KevinEppacher/Awesome_Gripper/Bewegungsanalyse/SolidWorks/BA_Folge_3.JPG

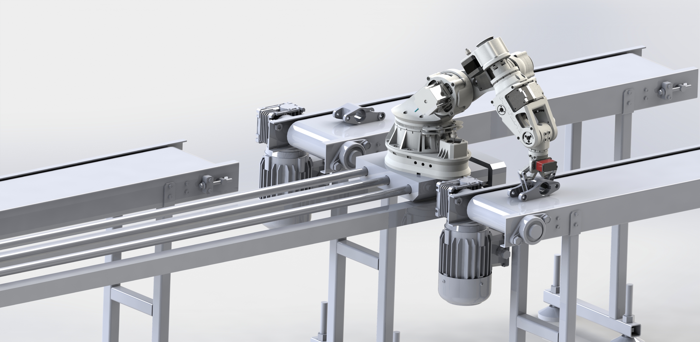
Bewegungsanalyse/SolidWorks/BA_Folge_3.JPG
