KevinEppacher/Awesome_Gripper/Bewegungsanalyse/SolidWorks/BA_Folge_1.JPG

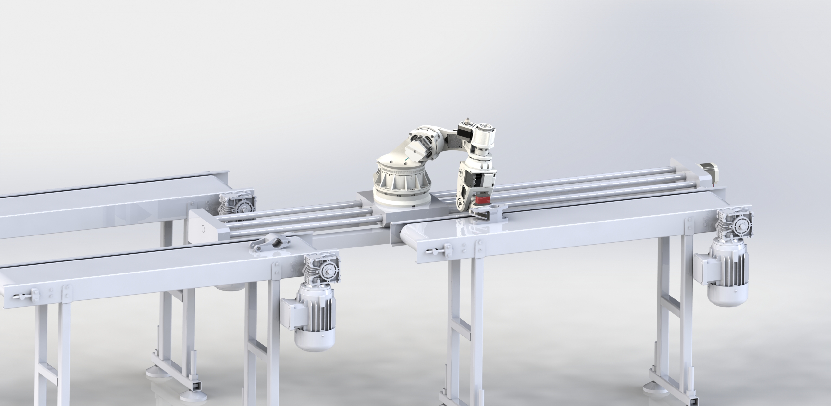
Bewegungsanalyse/SolidWorks/BA_Folge_1.JPG
