KevinEppacher/Awesome_Gripper/README.md

# Awesome_Gripper
Mechanical Gripper Development
