KevinEppacher/Awesome_Gripper/Dokumentation und Berechnung/Awesome_Gripper.docx

## Produktdesign und Produktentwicklung

## Greifer Entwicklung

Kevin Eppacher

Moritz Dönges

# Greif-Aufgabenstellung

Ziel ist es ein Werkstück, wie in Abbildung 1 dargestellt, von einem Förderband zu entnehmen und mittels einem geeigneten Endeffektor auf einem 6-Achs-Knickarm Roboter auf zwei Förderbänder abwechselnd zu manipulieren.

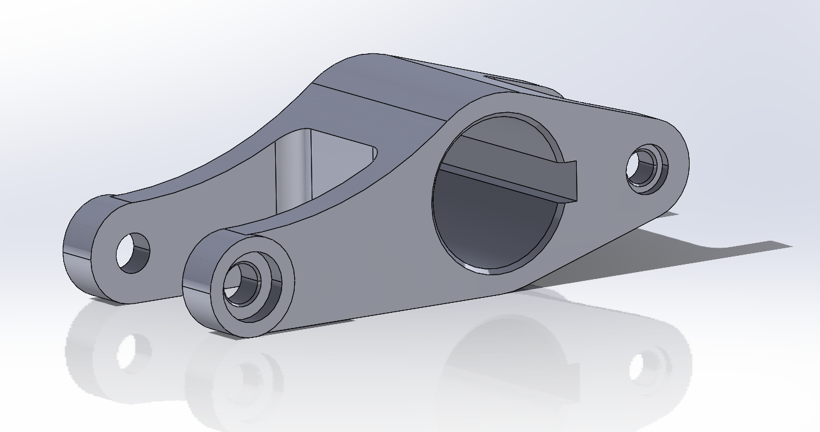
[picture p3: figure]

Abbildung 1: Werkstück

In Abbildung 2 ist die Anlage veranschaulicht. Die bearbeiteten Werkstücke kommen mittels einem Gurt-Förderband, welche durch einen Seitenanschlag positioniert werden. Die endgültige Position längs in Fahrtrichtung des Förderbandes, wird durch eine 2D-Kamera ermittelt, sodass der Roboter variabel die Werkstücke aufnehmen kann. Die Taktzeit beträgt 5 s vom Zeitpunkt der Entnahme des Werkstückes bis zur nächsten Entnahme des Werkstückes. Aus Taktzeitgründen, wird vorgesehen, dass ein Leichtbau Manipulator auf einer linear Schiene verfahrbar ist, um Werkstücke bereits am Anfang des Förderbandes zu entnehmen. Dies ermöglicht es, vorübergehend einen Zeitpuffer aufzubauen.

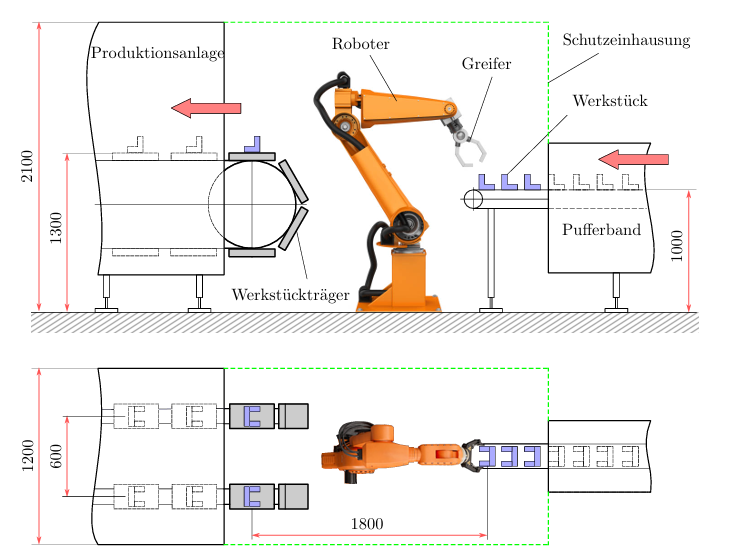
[picture p4: figure]

Abbildung 2: Anlagen Skizze

In Abbildung 3 (rechts) wird dargestellt, in welcher Orientierung das Werkstück auf dem Förderband ankommt und wie das Werkstück in welcher Orientierung platziert und abgeführt wird (links).

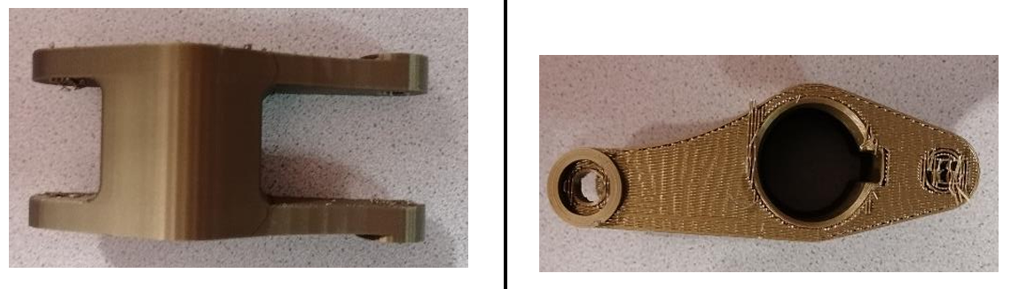
[picture p5: figure]

Abbildung 3: Bauteil Orientierung (Rechts – Zuführung | Links Abführung)

# Konstruktives Schema

Für die gegebene Aufgabenstellung wird ein parallel Backengreifer vorgesehen, mit einer kreisschiebenden Bewegung. Ein Parallel-Backengreifer mit Kreisschiebung kombiniert die Vorteile eines stabilen und kraftvollen Greifmechanismus mit hoher Präzision und Verschleißarmut. Er eignet sich besonders für automatisierte Produktionsprozesse, in denen eine zuverlässige und wiederholbare Bauteilhandhabung erforderlich ist.

Die Auslegung des Greifers hängt von folgenden Faktoren ab:

- Greif Merkmale
- Greifkraft
- Greifvolumen

Das Werkstück in Abbildung 1 eignet sich optimal mittig auf den seitlichen parallelen Flächen zu greifen. Der Abstand zwischen beiden Flächen beträgt 42 mm. Somit muss der Greifer für mindestens 42 mm ausgelegt werden, indem die Hebelarme des Parallel-Backengreifers dementsprechend lang genug konstruiert wird. Die notwendige Greifkraft wird in Kapitel “Greifkraft und Antrieb Berechnung“ näher erläutert. In Abbildung 4 ist eine schematische Skizze des Greifers dargestellt. Der Ordnungszustand des Werkstückes wird durch den Positionierungsgrad und dem Orientierungsgrad ermittelt. Obwohl das Werkstück auf dem Förderband mit einem seitlichen Anschlag zentriert wird, kann es sich in Längsrichtung des Förderbandes und in Querrichtung entlang der Auflagefläche frei bewegen. Zusätzlich kann das Werkstück sich auf dem Förderband entlang der z-Achse (orthogonal zur Auflagefläche des Förderbandes) frei bewegen. Aus dem ergibt sich folgender Positionierung (PG)-und Orientierungsgrad (OG):

PG: 1

OG: 1

Aus dem ergibt sich der ein Ordnungszustand (OG) von 1 (OG/PG). Ein OZ von 1 bedeutet, dass das Werkstück teilgeordnet im Raum ist. Um die Pose (bestehend aus Position und Orientierung) zu ermitteln, wird eine 2D-Kamera verwendet, um das Bauteil entlang und quer zum Förderband zu lokalisieren und um die Orientierung zu ermitteln.

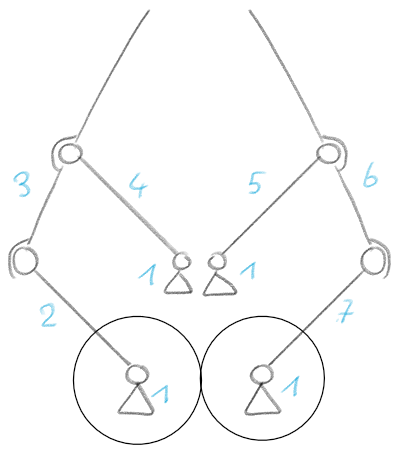
[picture p6: figure]
Freihandzeichnungen Freihandzeichnungen Freihandzeichnungen Freihandzeichnungen Freihandzeichnungen Freihandzeichnungen Freihandzeichnungen Freihandzeichnungen Freihandzeichnungen Freihandzeichnungen Freihandzeichnungen Freihandzeichnungen Freihandzeichnungen Freihandzeichnungen Freihandzeichnunge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

Abbildung 4: Schematische Skizze des Parallelbackengreifers

Das Bauteil besitzt mit dem vorgesehenen Greifer zwei Freiheitsgrade, da es sich entlang der Greiffläche bewegen kann. Diese Bewegungsmöglichkeit wird jedoch durch den erforderlichen Kraft- und Reibschluss kompensiert. Der Greifer setzt sich aus sieben Gliedern, acht Drehgelenken und einer kinematischen Zwangsbedingung zwischen dem Antriebszahnrad und dem Abriebzahnrad zusammen. In Abbildung 5 wird die kinematische Kette des Endeffektors illustriert, welches die Struktur und Anordnung der einzelnen Glieder sowie die Verbindungselemente darstellt. Die Kinematik des Systems basiert auf einer geschlossenen Viergelenkkette mit zusätzlichen Verbindungen, die eine synchrone Bewegung der Greifbacken ermöglichen.

Die nummerierten Gelenke in Abbildung 5 zeigen die Hauptbewegungspunkte des Mechanismus, wobei die Glieder durch Drehgelenke gekoppelt sind. Der zentrale Bereich (Glied 1) dient als Basisstruktur, an der die übrigen beweglichen Elemente angebracht sind. Durch die Zwangsbedingung zwischen dem Antriebszahnrad und dem Abriebzahnrad wird eine gleichmäßige Kraftübertragung auf beide Greifseiten gewährleistet, sodass eine symmetrische und präzise Greifbewegung ermöglicht wird.

Weiterhin sorgt die gewählte Kinematik für eine gleichmäßige Verteilung der Greifkräfte auf das Bauteil, wodurch eine zuverlässige Handhabung sichergestellt wird. Dies ist besonders wichtig, da sich das Werkstück entlang der Greiffläche bewegen könnte, falls der Kraft- und Reibschluss nicht ausreicht. Die Mechanik des Greifers minimiert dieses Risiko durch eine kontrollierte Bewegung und eine stabile Haltekraft.

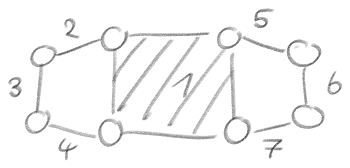
[picture p7: figure]
Freihandzeichnungen Freihandzeichnungen Freihandzeichnungen Freihandzeichnungen Freihandzeichnungen Freihandzeichnungen Freihandzeichnungen Freihandzeichnungen Freihandzeichnungen Freihandzeichnungen Freihandzeichnungen Freihandzeichnungen Freihandzeichnungen Freihandzeichnungen Freihandzeichnunge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

Abbildung 5: Kinematische Kette des 7-gliedrigen Greifers

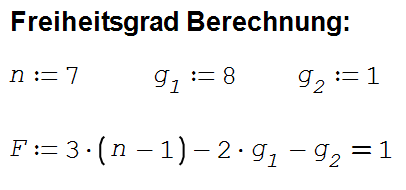
[picture p8: figure]

# Greifkraft und Antrieb Berechnung

Randbedingungen für die Greifkraft Berechnung:

- Masse = 0.42 kg
- Taktzeit = 5 s
- Roboter maximale TCP-Geschwindigkeit = 1.2 m/s

Die Masse des Werkstückes wurde in SolidWorks (SW) mittels den Materialeigenschaften (0.7050 Gusseisen) ermittelt. Die Taktzeit wurde vorgegeben durch die Materialflussgeschwindigkeit der vorherigen Anlage und eine maximale TCP-Geschwindigkeit von 1.2 m/s.

Folgende Annahmen wurden für die Greifkraft Berechnung angenommen:

Sicherheit = 2

Reibkoeffizient = 0.45

Um etwaige Modellunsicherheiten zu kompensieren, wurde mit einer Sicherheit von 2 gerechnet und der Reibkoeffizient ergibt sich aus den Materialeigenschaften zwischen Gummi (TPU) und Gusseisen (0.7050) und wurde aus den Kenndaten im Buch [1] ermittelt.

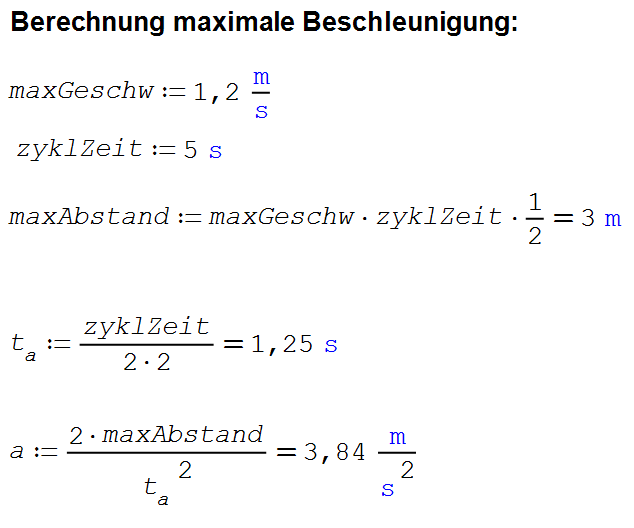
[picture p9: figure]

Der maximale Abstand zwischen der Pick- und Place-Position wird berechnet, indem die maximale Geschwindigkeit mit der halben Taktzeit multipliziert wird.

Zur vereinfachten Berechnung der maximalen Beschleunigung beim Anheben des Werkstücks wird angenommen, dass die Geschwindigkeit zu Beginn v=0 ist und die Beschleunigung ihren Höchstwert bei der Hälfte des Verfahrwegs erreicht.

Mithilfe der allgemeinen Bewegungsgleichung wird die Beschleunigung a hergeleitet. Da sowohl die Zeit, zu der die maximale Beschleunigung auftritt, als auch der maximale Abstand bekannt sind, kann die Beschleunigung direkt berechnet werden.

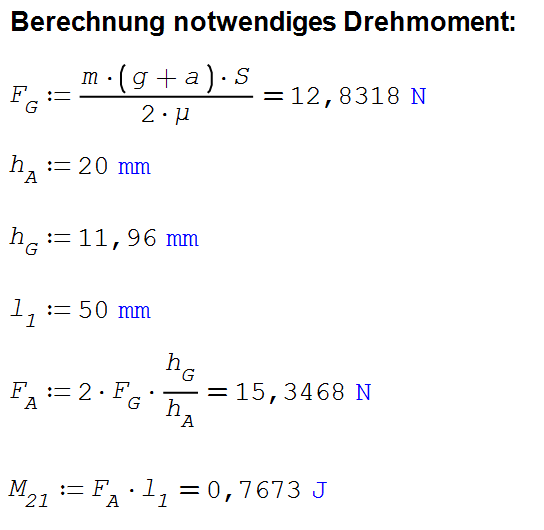
[picture p10: figure]

Dadurch dass zwei Greiferbacken das Werkstück abhängig der Gravitationsbeschleunigung und der höchst Beschleunigung mit einem Reibkoeffizienten μ festhalten, kann die notwendige Greifkraft berechnet werden. Mittels der h-Strecken Methode, wird im Punkt A (Abbildung 6) die notwendige Kraft berechnet, durch den h-Strecken Verhältnis am Greifpunkt relativ zu Punkt A. Aus der Länge des Hebels für Glied 2 und 7 (Abbildung 4), kann das notwendige Moment berechnet werden.

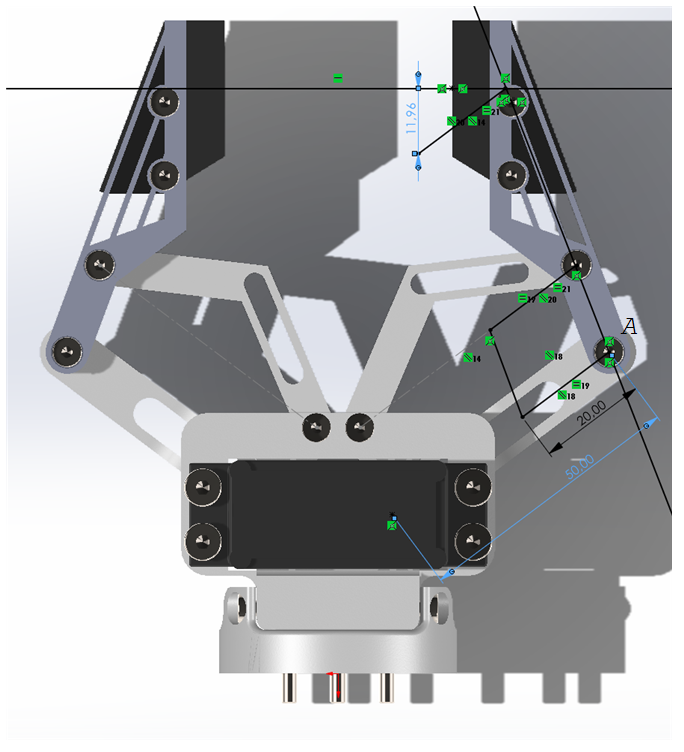
[picture p11: figure]

Abbildung 6: Grafische Berechnung der Kraft im Punkt A mittels der h-Strecken Methode

Es wurde ein Servo DC-Motor mit einem Drehmoment von 20 kgcm bzw. 1.96 Nm vorgesehen. Aus dem notwendigen Moment und dem Drehmoment des Servo Motors, ergibt sich eine Sicherheit von über 2.5.

# Analytische und Numerische Auslegung

Es wurde eine analytische Festigkeitsberechnung für Glieder 2 und 7 berechnet (siehe Abbildung 4), da es durch den vorgesehenen Design Material Ersparnis, aufgrund der kleinen Fläche zur höchsten Spannung führen könnte. Die Zugspannung lässt sich geometrisch ableiten (siehe Abbildung 7), indem die am Punkt A wirkende Kraft in ihre Längs- und Querkomponenten zerlegt wird.

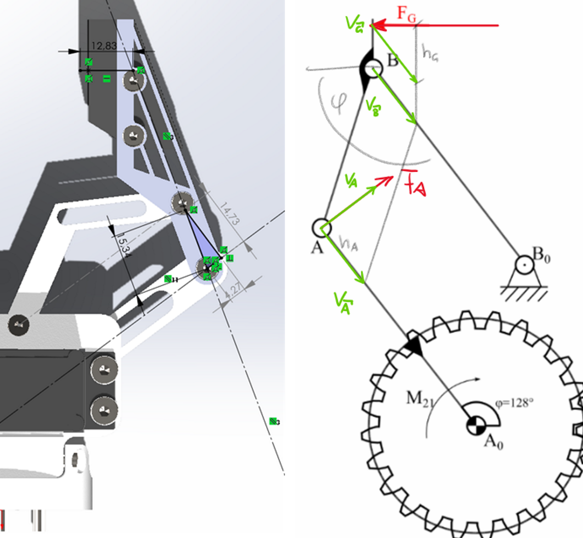
[picture p12: figure]

Abbildung 7: Geometrische Herleitung der Zugspannung auf das 2 und 7 Glied des Endeffektors

Mittels des Querschnittes des Bauteils, welches mittels SolidWorks ermittelt wurde, kann die Spannung in folgender Gleichung berechnet werden.

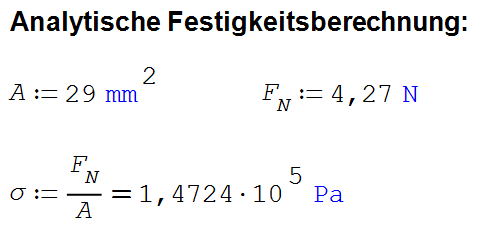
[picture p13: figure]

Im Dokument unter "Awesome_Gripper/Dokumentation und Berechnung/PLA_Materialeigenschaften.pdf" ist die Streckspannung des verwendeten PLA-Materials aufgeführt. Diese wird in der folgenden Berechnung zur Ermittlung des Sicherheitsfaktors verwendet, indem die auf das Bauteil wirkende Spannung durch die Streckspannung dividiert wird.

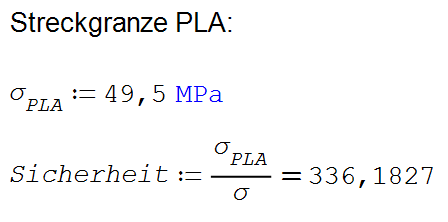
[picture p14: figure]

Daraus ergibt sich ein Sicherheitsfaktor von 336.

# Konstruktive Gestaltung

Die Konstruktion und die FE-Analyse wurden in Autodesk Fusion 360 umgesetzt. Der Greifer setzt sich aus 7 verschiedenen Teilen zusammen, wobei der Finger 4-mal und Tip und Support Lever 2-mal verbaut sind (siehe Zeichnung).

Element | Anzahl | Bauteil
1 | 1 | Baseplate | PLA
2 | 1 | Frame | PLA
3 | 1 | Lever | PLA
4 | 2 | Support Lever | PLA
5 | 4 | Finger | PLA
6 | 2 | Tip | TPU
7 | 1 | Offset Lever | PLA

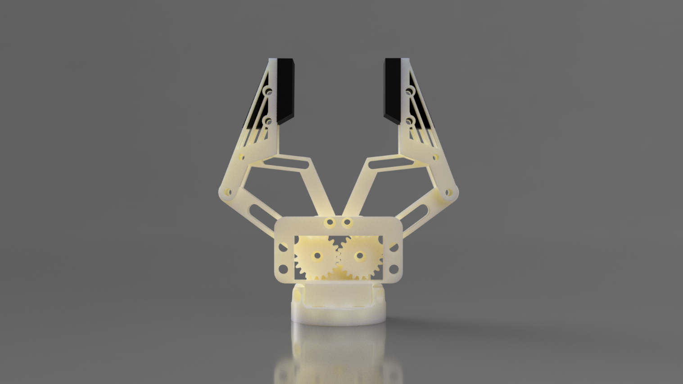
[picture p15: figure]

Abbildung 8: Greifer Baugruppe

# Ergebnisse FE-Analyse

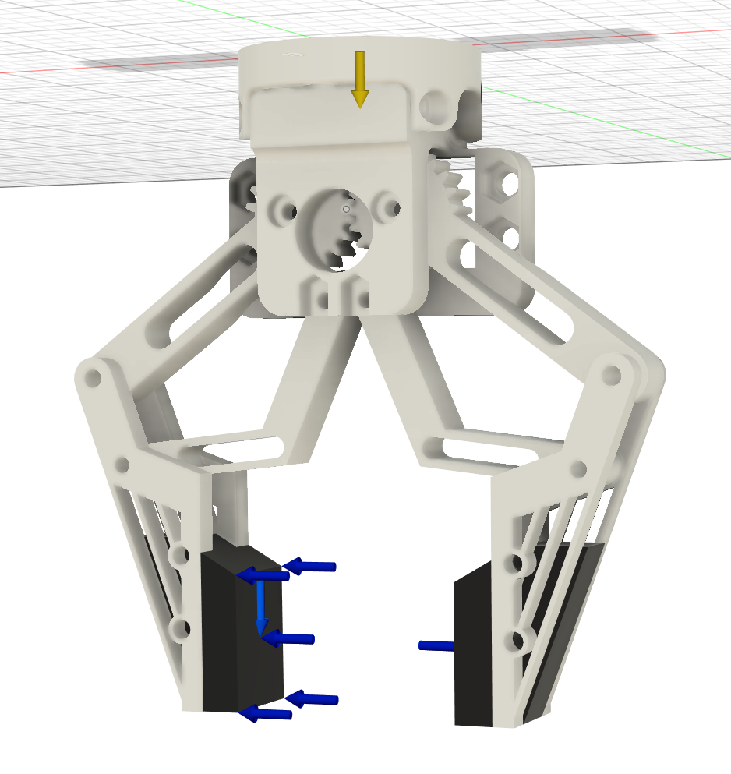
[picture p16: figure]

In Autodesk Fusion 360 wurde der Lastfall bei geschlossenem Greifer simuliert. Hierbei sind die Greiferbacken (Tip) 42 mm geöffnet. Die Greifkraft von 12.832 N wirkt auf die Greiferbacken, während die Normalkraft (Reibkraft) des Bauteils an den Oberflächen der Greiferbacken, durch die Schwerkraft, nach unten wirkt. Da das Bauteil mit dem Greifer gegriffen und nach oben bewegt wird, ergibt sich mit einer Bewegungsbeschleunigung von 3,84 m/s² eine Reibkraft von 2.882 N pro Greifbacke. Zudem wirkt die Schwerkraft, welche in der FE-Analyse als gelber Pfeil dargestellt ist.
Weitere Ergebnisse sind der Autodesk.html aus dem Ordner „Dokumentationen und Berechnung zu entnehmen.

Abbildung 9: Simulationskonfiguration der FE-Analyse. Greifkraft (dunkel Blau), Reibkraft (Blau), Schwerkraft (Gelb)

Ergebnisse

Die Baugruppe wurde auf Dehnung, Spannung und Verschiebung getestet:

Dehnung

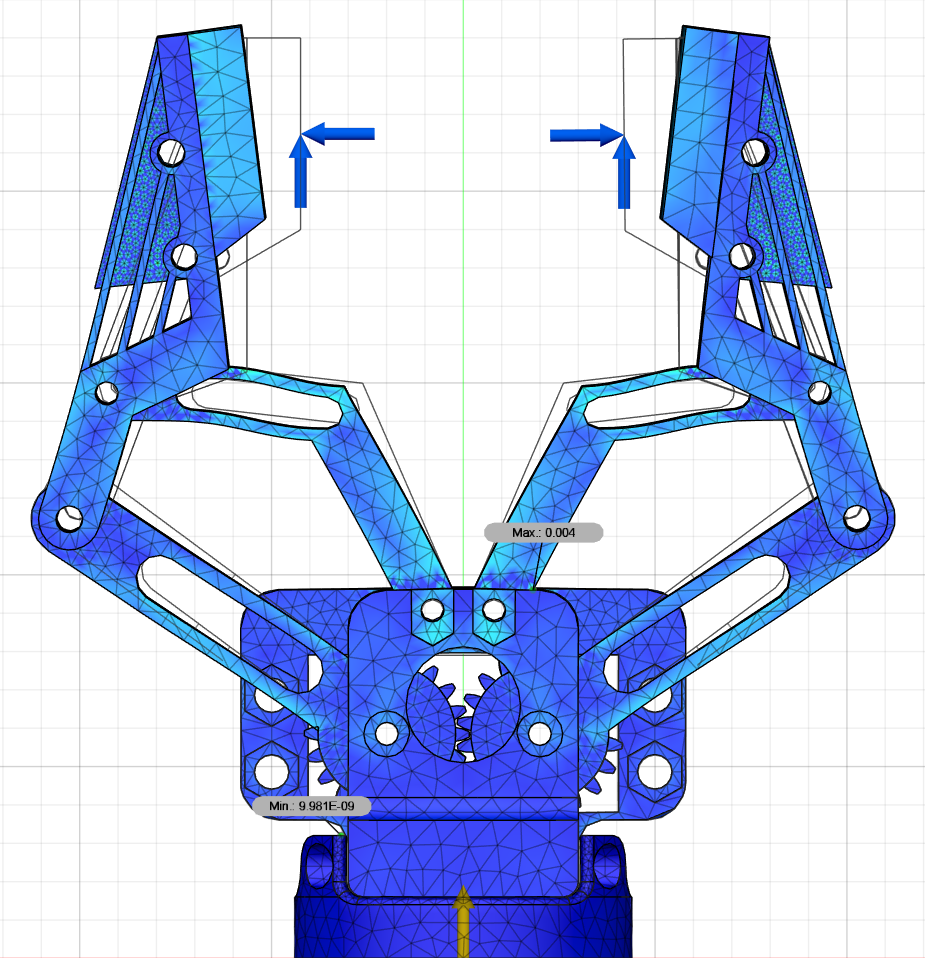
[picture p17: figure]

Abbildung 10: Ergebnisse für Dehnung der Baugruppe. Kritische Stelle an beiden Support Lever bei 0.004

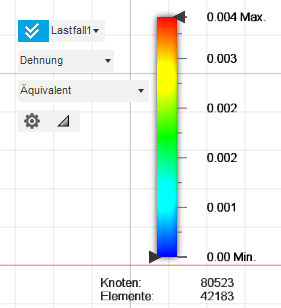
[picture p18: figure]
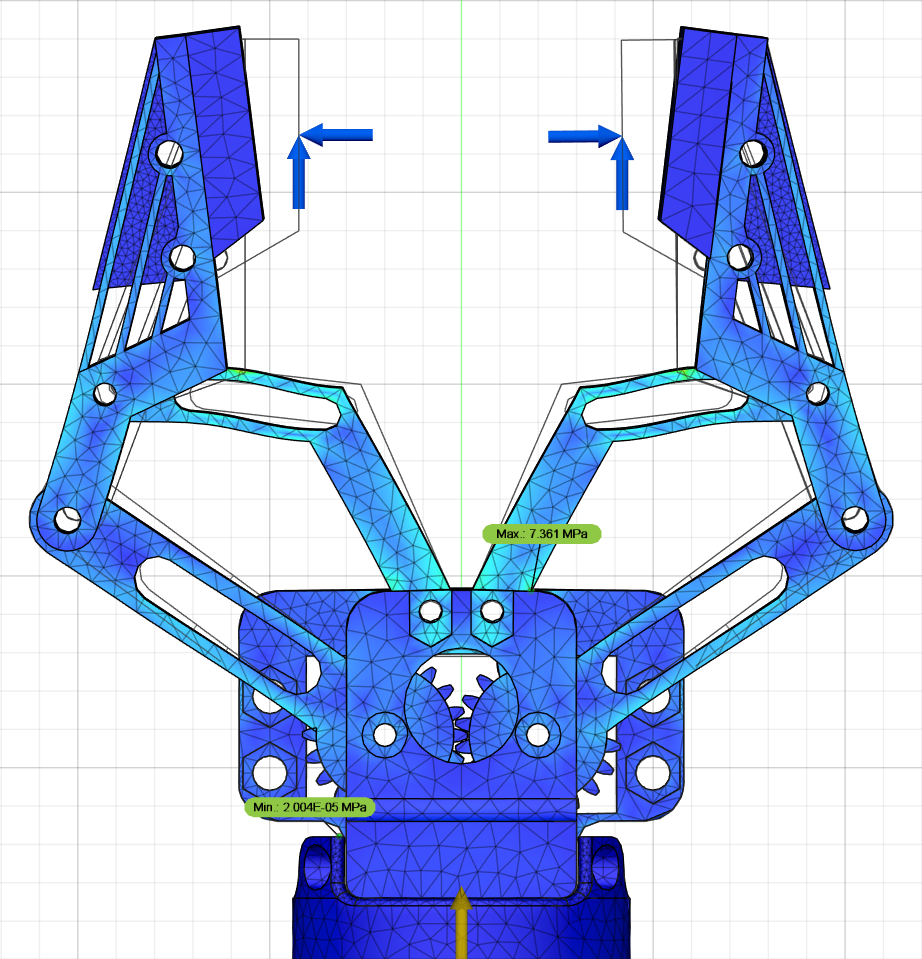
[picture p19: figure]

Spannung

Abbildung 11: Ergebnisse für Spannung in der Baugruppe: Kritische Stelle an Support Lever mit einer Spannung von 7.361 Mpa

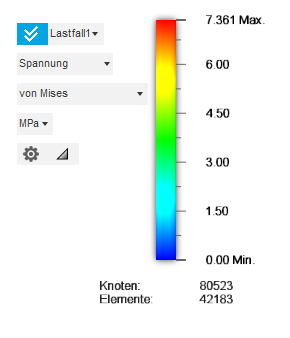
[picture p20: figure]
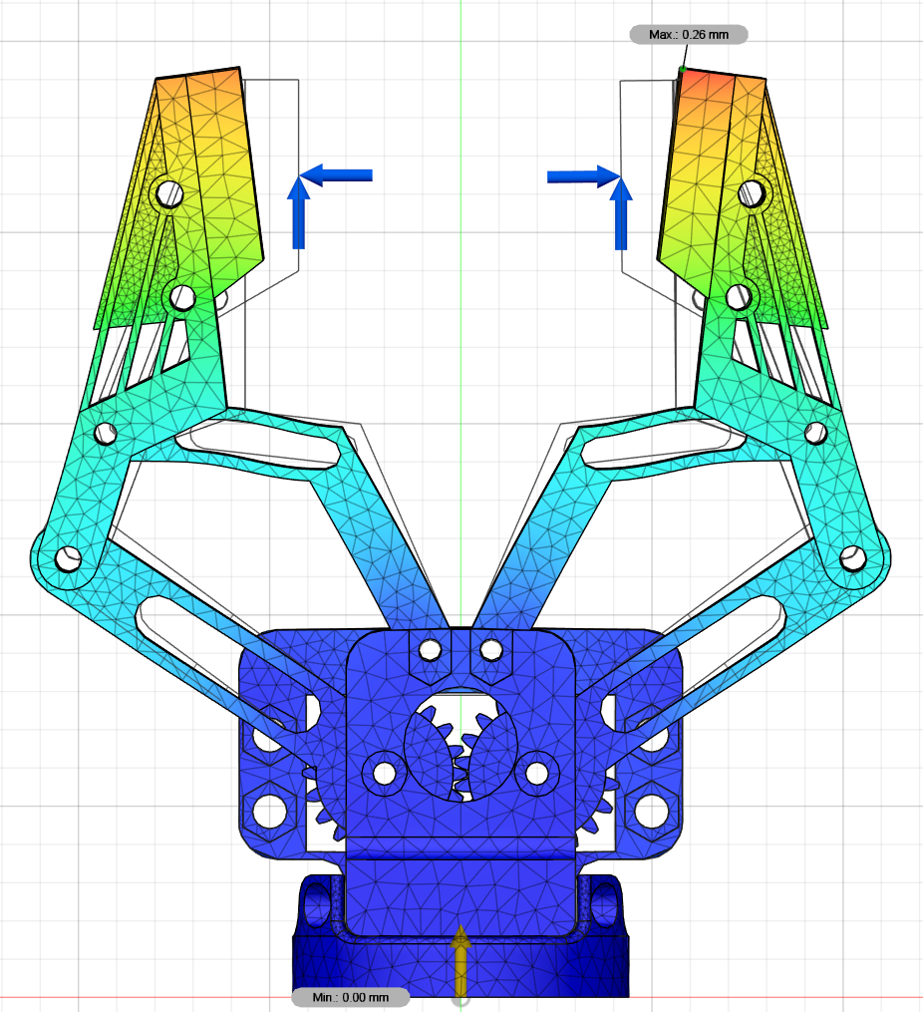
[picture p21: figure]

Verschiebung

Abbildung 12: Ergebnisse für Verschiebung in der Baugruppe: Kritische Stelle an Greiferbacken (Tip) mit 0.26 mm. Die Greiferbacken sind aus TPU, weshalb die Größe Verschiebung an den Greiferbacken auftritt.

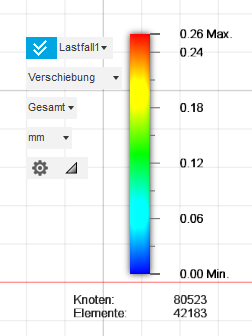
[picture p22: figure]

Sicherheitsfaktor:

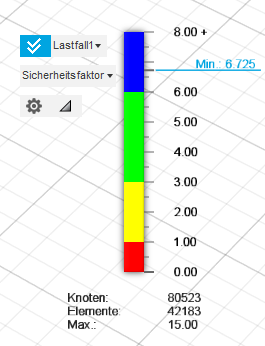
[picture p23: figure]

Abbildung 13: Der Sicherheitsfaktor ergibt sich bei einem Minimum von 6.725

# Additive Fertigung der Greifer-Baugruppe

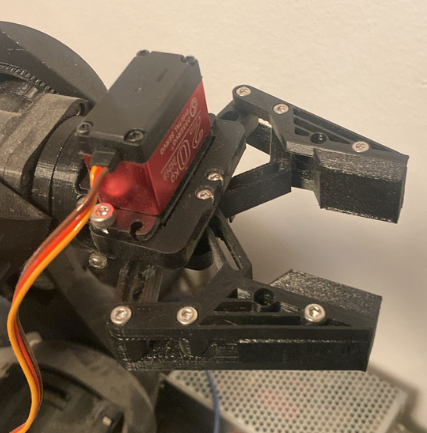
[picture p24: figure]

Der Greifer wurde in der Variante mit 32mm Griffweite, für einen 6 Achs Roboterarm, im 3D Drucker gefertigt und am Roboterflansch verschraubt.
Hier kommt das Schnellwechselsystem zum Tragen. Solange die Baseplate am Roboter montiert ist, kann jedes andere Werkzeug mit dem passenden System an der Baseplate angebracht werden. Außerdem muss für jede Type von Roboterflansch lediglich die Baseplate angepasst werden, um den Greifer anschließend zu montieren und zu verwenden.

Abbildung 14: Gefertigte Greifer-Baugruppe

Abbildungsverzeichnis

# Literaturverzeichnis

References

[1] Gomeringer, R., Kilgus, R., Menges, V., et al.: ‘Tabellenbuch Metall: Mit Formelsammlung’ (Verlag Europa-Lehrmittel Nourney Vollmer GmbH & Co. KG, Haan-Gruiten, 2024, 49th edn.)

www.technikum-wien.at
