KevinEppacher/Awesome_Gripper/Bewegungsanalyse/catkin_ws/src/six_dofra_moveit_config_v3/image.png

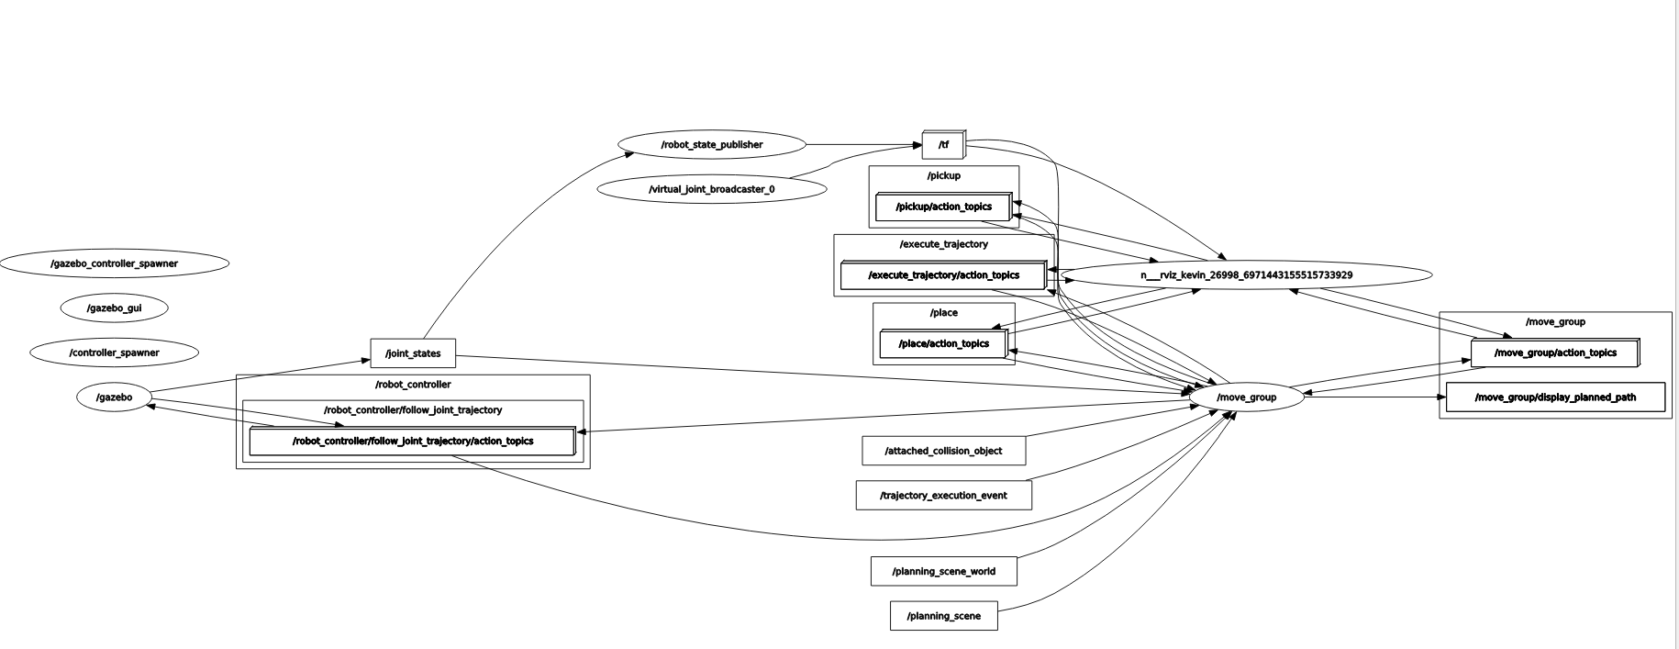
Bewegungsanalyse/catkin_ws/src/six_dofra_moveit_config_v3/image.png
