KevinEppacher/Awesome_Gripper/Bewegungsanalyse/catkin_ws/src/Trash/gripper_config_v2/image.png

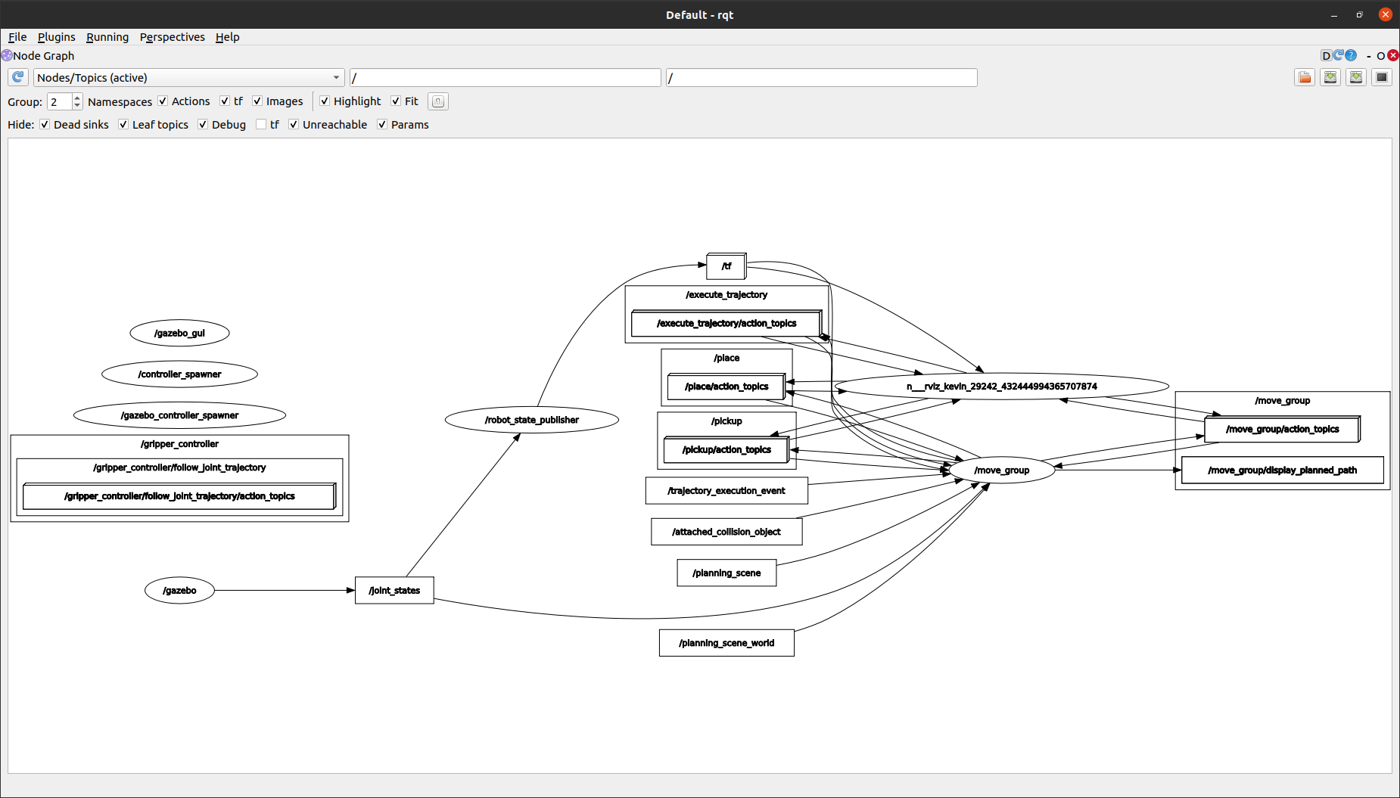
Bewegungsanalyse/catkin_ws/src/Trash/gripper_config_v2/image.png
