KevinEppacher/Awesome_Gripper/Bewegungsanalyse/SolidWorks/BA_Folge_2.JPG

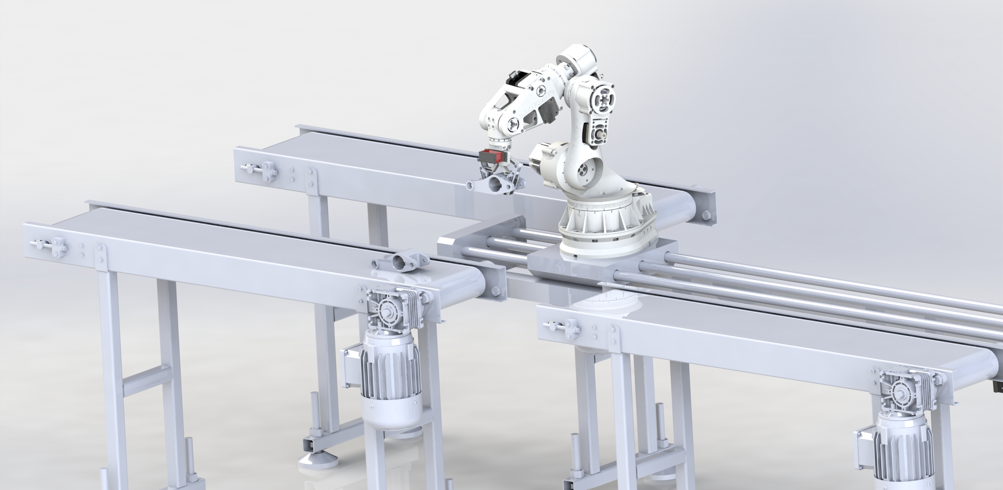
Bewegungsanalyse/SolidWorks/BA_Folge_2.JPG
