KevinEppacher/Awesome_Gripper/Konstruktionsdaten/Assembly/Robot/Gelenk_1_V3.0.SLDASM

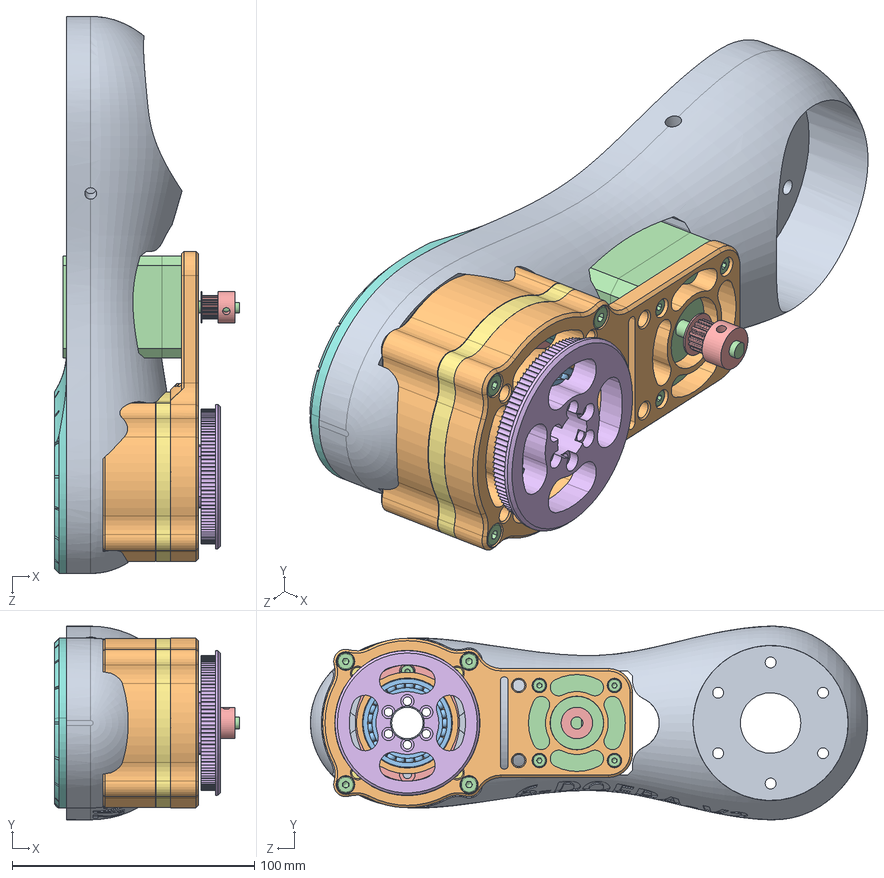
[picture p28: CAD file, 2024-10-17]
Konstruktionsdaten/Assembly/Robot/Gelenk_1_V3.0.SLDASM
76.5 x 80.0 x 230.0 mm
Gelenk_1_Frame_3.0
Circular_Spline_G1
6805_Radial_Bearring x 3
Nema_17_48mm
Zahnriemenscheibe_Base_Motor
Gaering_Circular_Spline
Circular_Spline_Teeth_G1
Flex_Spline_G1
Flex_Spline_Case_G1
Circular_Spline_Case_G1
Strain_Wave_Kupplung_G1
socket head thin cap screw_din x 9
Wave_Generator_1
radial ball bearing_68_din
Wave_Generator_2
Kugellager_Halter_Gelenk_1_V2
