KevinEppacher/Awesome_Gripper/Konstruktionsdaten/Parts/Robot/Gelenk_3.SLDASM

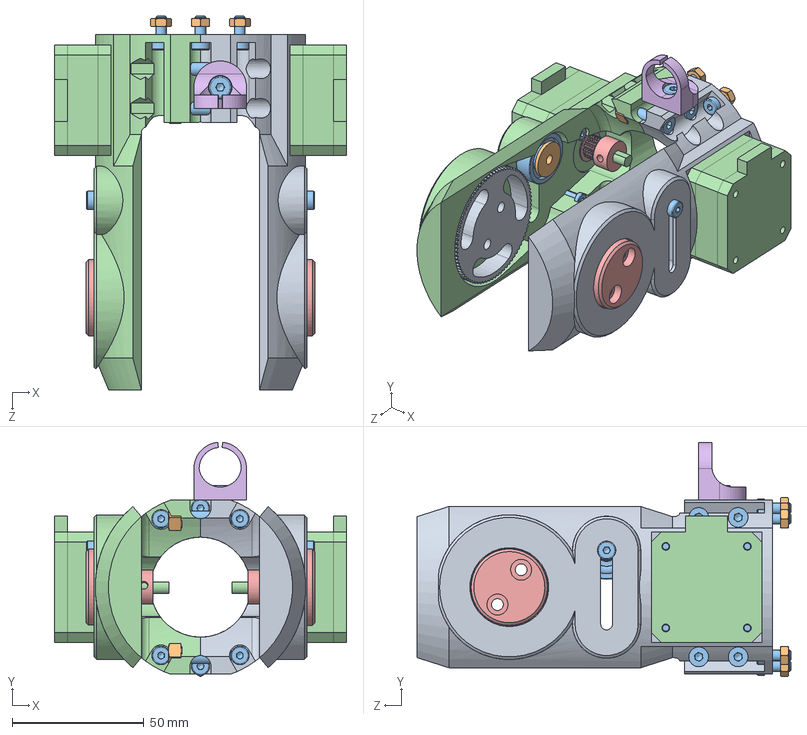
[picture p29: CAD file, 2024-10-17]
Konstruktionsdaten/Parts/Robot/Gelenk_3.SLDASM
111.0 x 89.1 x 142.0 mm
Gelenk_3_Frame_links
hex nut style 1 gradeab_din x 10
socket head thin cap screw_din x 21
Nema_17_20mm x 2
Zahnriemenscheibe_Base_Motor x 2
G3_Zahnriemenscheibe x 2
G3_Kugellager_Halterung x 2
radial ball bearing_68_din x 2
Gelenk_3_Frame_rechts
G3_Halterung x 2
Kabelklemme
