KevinEppacher/Awesome_Gripper/Konstruktionsdaten/Assembly/Robot/Gelenk_2_V2.0.SLDASM

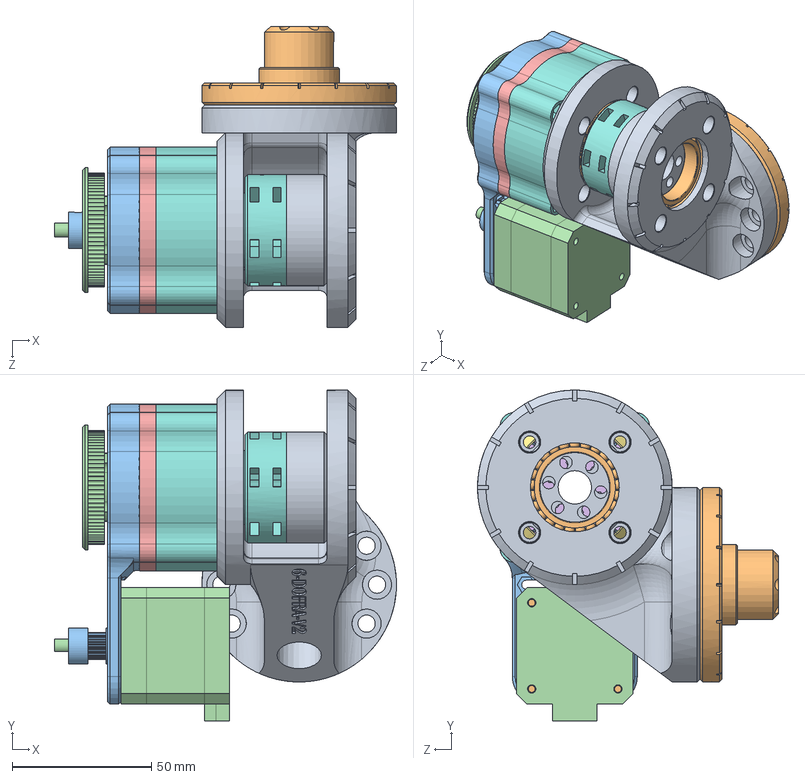
[picture p30: CAD file, 2024-10-17]
Konstruktionsdaten/Assembly/Robot/Gelenk_2_V2.0.SLDASM
123.0 x 119.0 x 108.2 mm
Frame_Gelenk_2
6805_Radial_Bearring x 4
Circular_Spline_G2
motor
Circular_Spline_Teeth_G2
Flex_Spline_G2
Flex_Spline_Case_G2
Circular_Spline_Case_G2
Strain_Wave_Kupplung_G2
socket head thin cap screw_din x 9
Zahnriemenscheibe_Base_Motor
Gearing_Circular_Spline_G2
G2_Wave_Generator_1
G2_Wave_Generator_2
radial ball bearing_68_din
Gelenk_2_Kupplungsbeilagsscheibe_V2
Kupplung_Blocker_G2
Kupplungsscheibe_Gelenk_1
