KevinEppacher/Awesome_Gripper/Konstruktionsdaten/Parts/Robot/Gelenk_4_V2.SLDASM

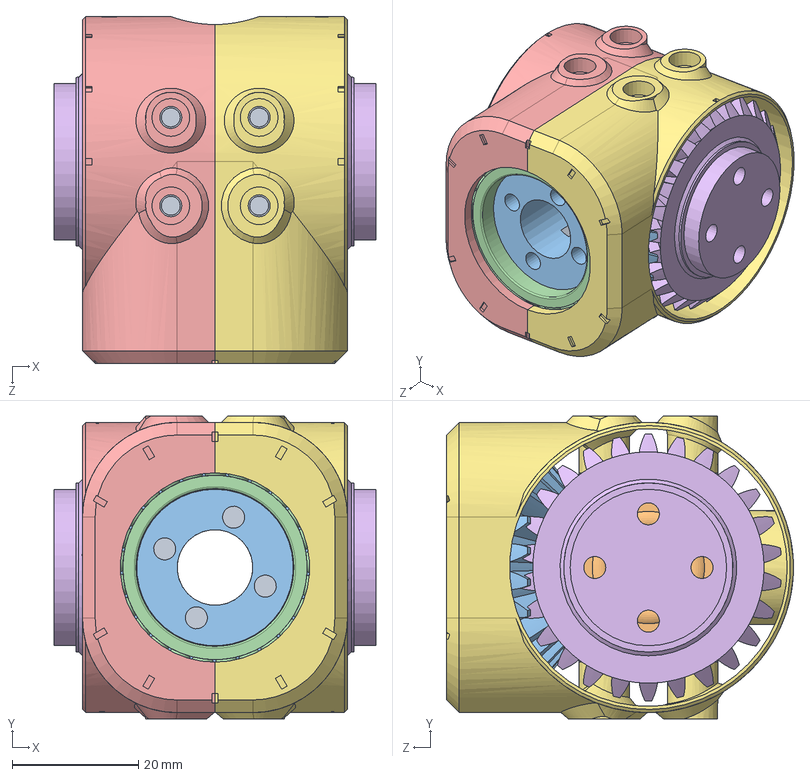
[picture p31: CAD file, 2024-10-17]
Konstruktionsdaten/Parts/Robot/Gelenk_4_V2.SLDASM
51.0 x 48.0 x 55.0 mm
Gelenk_4_Frame_V2
radial ball bearing_68_din x 2
Differenzial_Getriebe_Zahnrad_1
6805_Radial_Bearring
Gelenk_4_Frame_2_links_V2
Differenzial_Getriebe_Zahnrad_2 x 2
Gelenk_4_Frame_2_rechts_V2
