KevinEppacher/Awesome_Gripper/Konstruktionsdaten/Assembly/Robot/Gelenk_3_V3.SLDASM

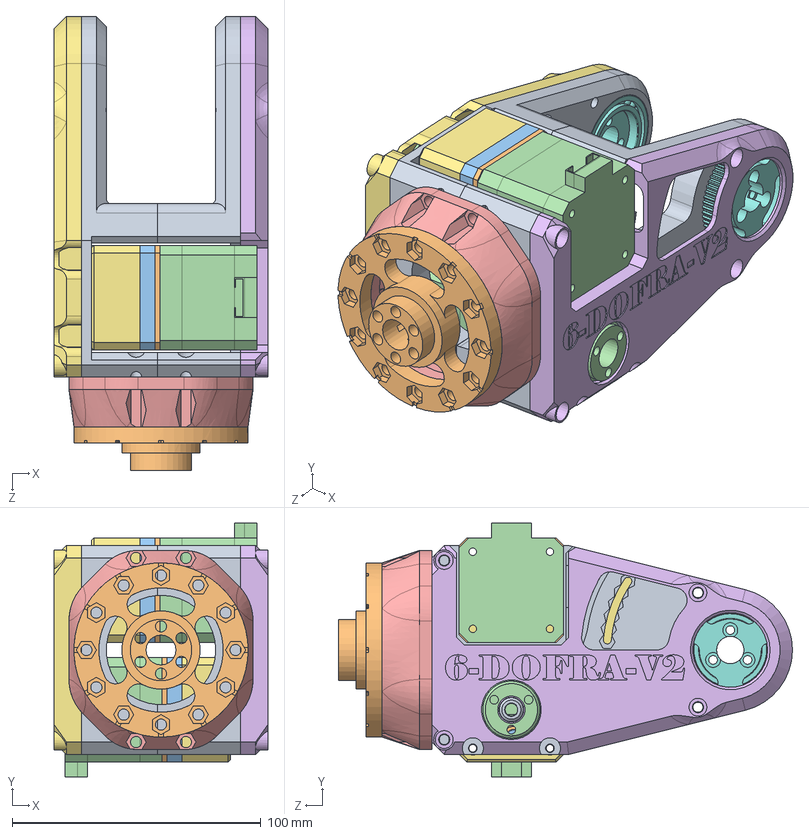
[picture p32: CAD file, 2024-10-17]
Konstruktionsdaten/Assembly/Robot/Gelenk_3_V3.SLDASM
86.0 x 102.0 x 182.5 mm
Frame_Gelenk_3_links_V3
Circular_Spline_G3 x 2
Circular_Spline_Teeth_G3 x 2
motor x 2
Flex_Spline_G3 x 2
Flex_Spline_Case_G3 x 2
Circular_Spline_Case_G3 x 2
6805_Radial_Bearring x 4
Wave_Generator_G3 x 2
radial ball bearing_68_din x 4
socket head thin cap screw_din x 4
Flex_Spline_Kupplung_2_G3 x 2
Adapter_Gelenk_3
Gelenk_3_Abdeckung_links
Gelenk_3_Abdeckung_rechts
Differential_Pulley x 2
Frame_Gelenk_3_rechts_V3
Kupplung _Gelenk_2_V2
