KevinEppacher/Awesome_Gripper/Konstruktionsdaten/Parts/Robot/Gelenk_4.SLDASM

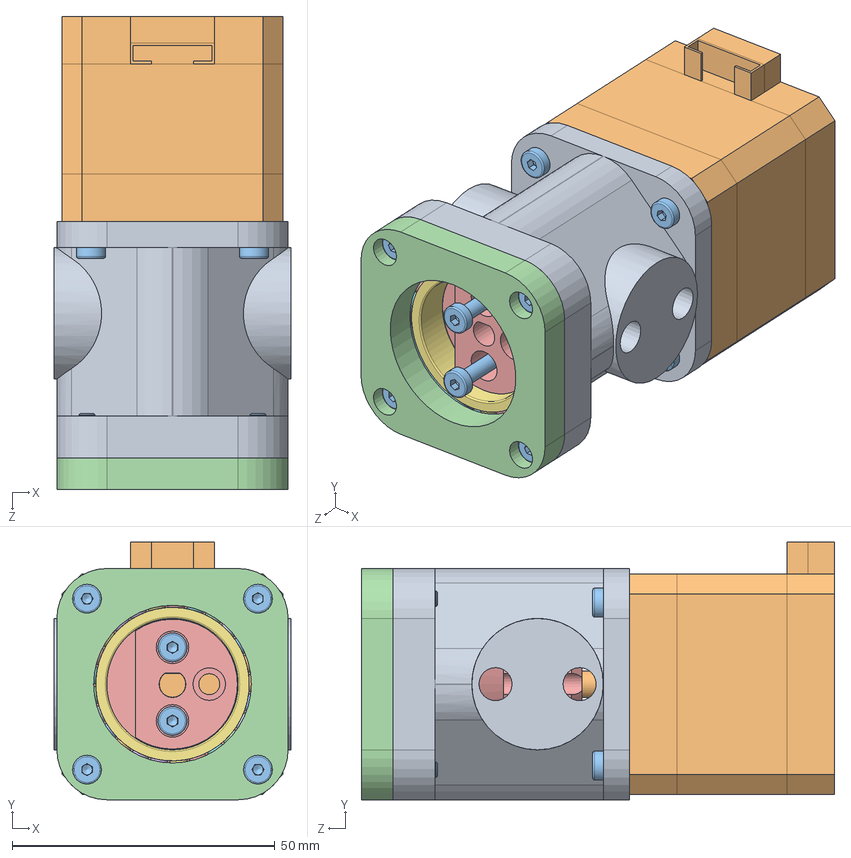
[picture p33: CAD file, 2024-10-17]
Konstruktionsdaten/Parts/Robot/Gelenk_4.SLDASM
45.0 x 49.0 x 90.0 mm
Gelenk_4_Frame
motor
socket head thin cap screw_din x 10
Gelenk_4_Case
Gelenk_4_Kupplung_Motor
