KevinEppacher/Awesome_Gripper/Konstruktionsdaten/Assembly/Robot/Gelenk_5.SLDASM

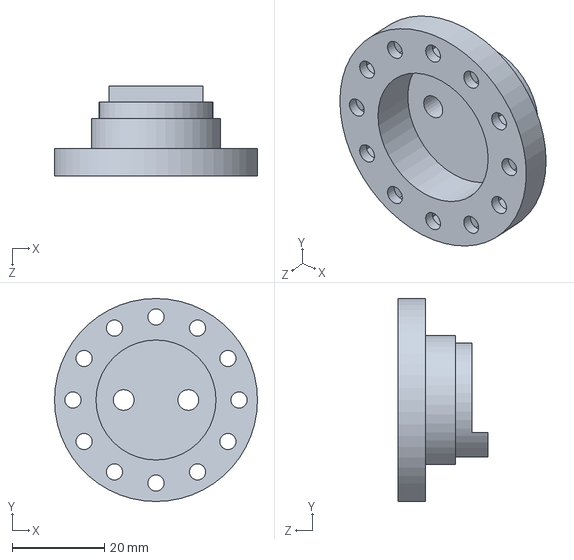
[picture p34: CAD file, 2024-10-17]
Konstruktionsdaten/Assembly/Robot/Gelenk_5.SLDASM
44.0 x 44.0 x 19.5 mm
