KevinEppacher/Awesome_Gripper/Konstruktionsdaten/Parts/Robot/Gelenk_1.SLDASM

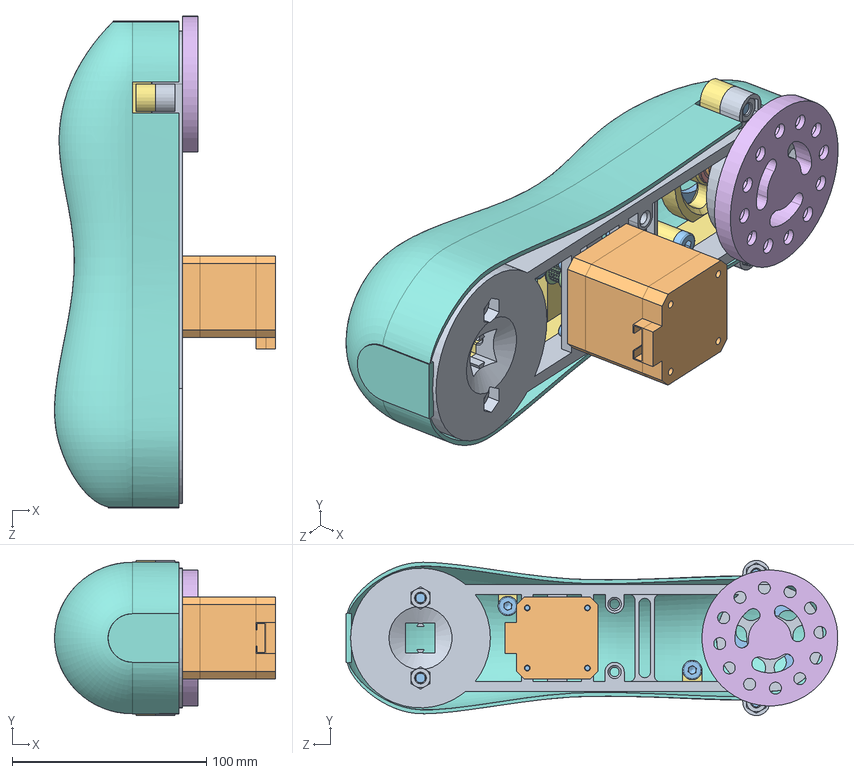
[picture p35: CAD file, 2024-10-17]
Konstruktionsdaten/Parts/Robot/Gelenk_1.SLDASM
113.8 x 80.0 x 253.2 mm
Gelenk_1_Frame_Innen
motor
socket head thin cap screw_din x 11
Zahnriemenscheibe_Base_Motor
radial ball bearing_68_din x 2
Kupplungsscheibe
Gelenk_1_Frame_Außen
Gelenk_1_Gehaeuse_Außen
hex nut gradec_din x 4
Zahnriemenscheibe_Gelenk_1
Gelenk_1_Lager
