KevinEppacher/Awesome_Gripper/Konstruktionsdaten/Parts/Robot/Assembly_Arm.SLDASM

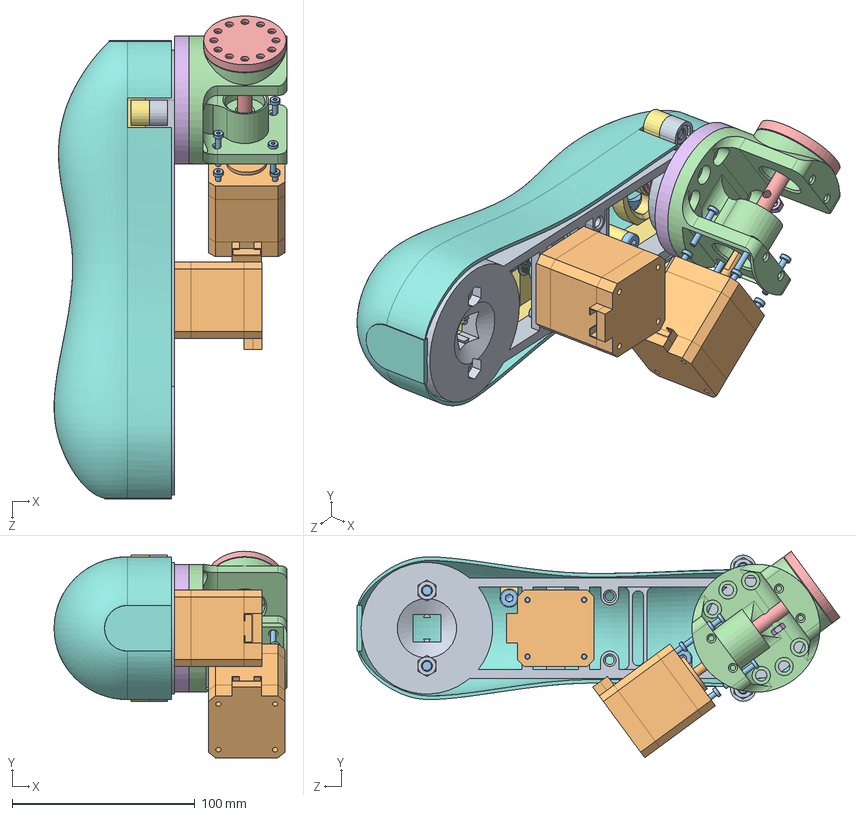
[picture p36: CAD file, 2024-10-17]
Konstruktionsdaten/Parts/Robot/Assembly_Arm.SLDASM
127.3 x 113.0 x 264.2 mm
Gelenk_1_Frame_Innen
motor x 2
socket head thin cap screw_din x 19
Zahnriemenscheibe_Base_Motor
radial ball bearing_68_din x 2
Kupplungsscheibe
Gelenk_1_Frame_Außen
Gelenk_1_Gehaeuse_Außen
hex nut gradec_din x 4
Zahnriemenscheibe_Gelenk_1
Gelenk_1_Lager
Gelenk_2_Frame
Kupplung _Gelenk_2
hex nut style 1 gradeab_din
