KevinEppacher/Awesome_Gripper/Konstruktionsdaten/Fusion 360 Greifer/Gripper_Baugruppe.stl

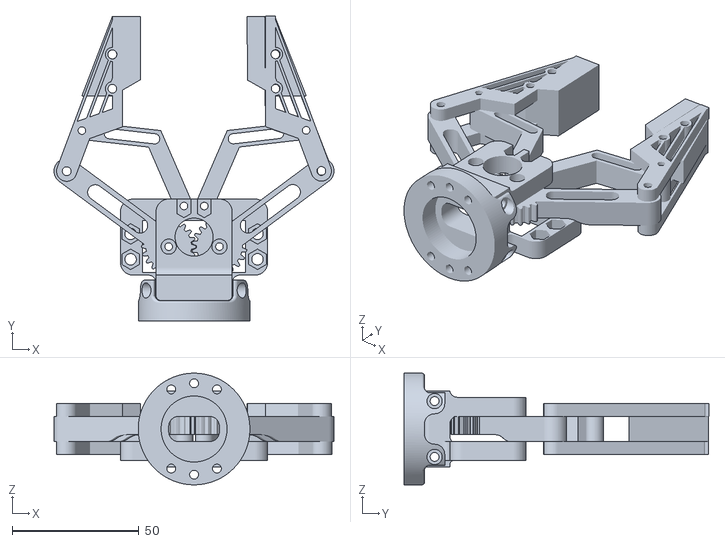
[picture p37: CAD file, 2025-02-12]
Konstruktionsdaten/Fusion 360 Greifer/Gripper_Baugruppe.stl
110.3 x 120.1 x 44.0
