KevinEppacher/Awesome_Gripper/Konstruktionsdaten/Parts/Robot/Gelenk_2.SLDASM

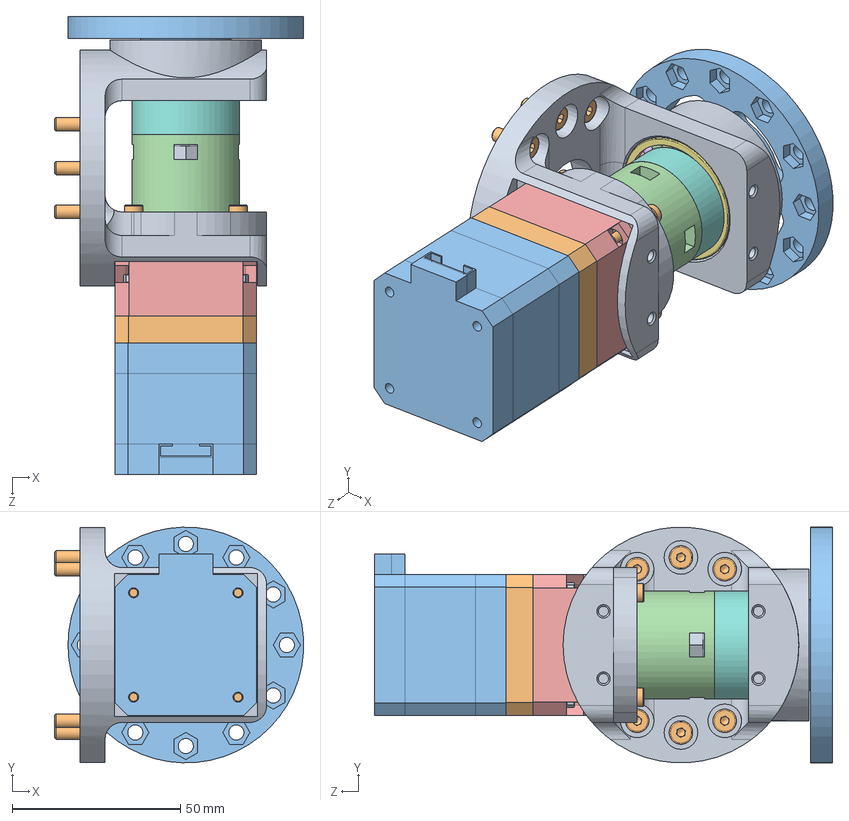
[picture p38: CAD file, 2024-10-17]
Konstruktionsdaten/Parts/Robot/Gelenk_2.SLDASM
73.9 x 70.0 x 136.0 mm
Gelenk_2_Frame
socket head thin cap screw_din x 18
Kupplung _Gelenk_2
Kupplung_2_Blocker
Gelenk_2_Kupplungsbeilagsscheibe
hex nut style 1 gradeab_din x 8
G2_Circular_Spline_Teeth
motor
G2_Flex_Spline
G2_Circular_Spline_Gehaeuse
G2_Flex_Spline_Kupplung
G2_Wave_Generator
G2_Wave_Generator_Case
radial ball bearing_68_din x 2
