KevinEppacher/Awesome_Gripper/Bewegungsanalyse/catkin_ws/src/Examples/robot/meshes/l5.STL

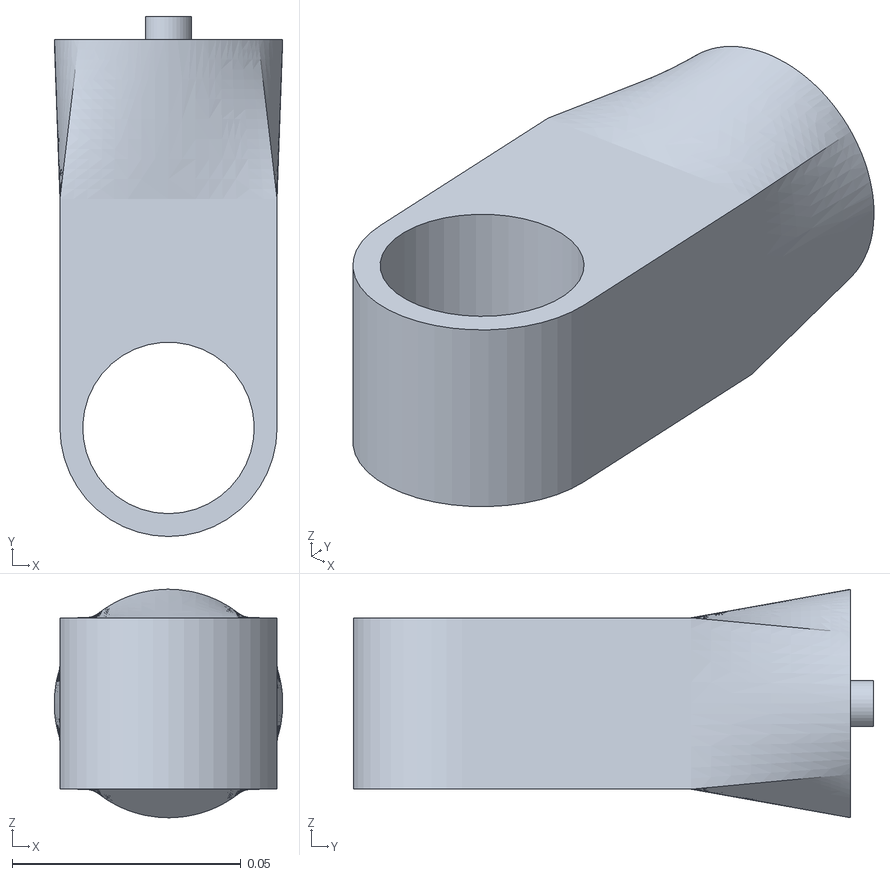
[picture p39: CAD file, 2024-10-22]
Bewegungsanalyse/catkin_ws/src/Examples/robot/meshes/l5.STL
0.05 x 0.114 x 0.05
