KevinEppacher/Awesome_Gripper/Bewegungsanalyse/catkin_ws/src/gripper/meshes/link_1_left.STL

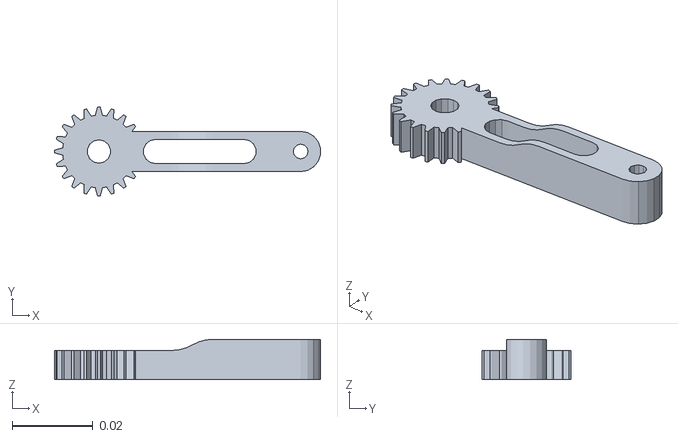
[picture p40: CAD file, 2024-10-27]
Bewegungsanalyse/catkin_ws/src/gripper/meshes/link_1_left.STL
0.0659 x 0.022 x 0.01
