KevinEppacher/Awesome_Gripper/Bewegungsanalyse/ros2_ws/src/descriptions/urdf_6_dofra_v3/meshes/linear_sledge.STL

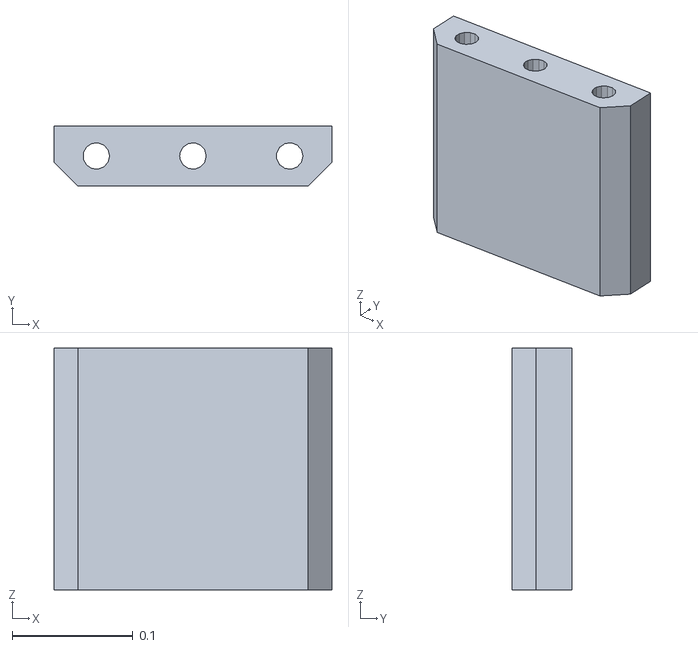
[picture p41: CAD file, 2024-10-17]
Bewegungsanalyse/ros2_ws/src/descriptions/urdf_6_dofra_v3/meshes/linear_sledge.STL
0.23 x 0.05 x 0.2
