KevinEppacher/Awesome_Gripper/Bewegungsanalyse/SolidWorks/Montaj.STEP

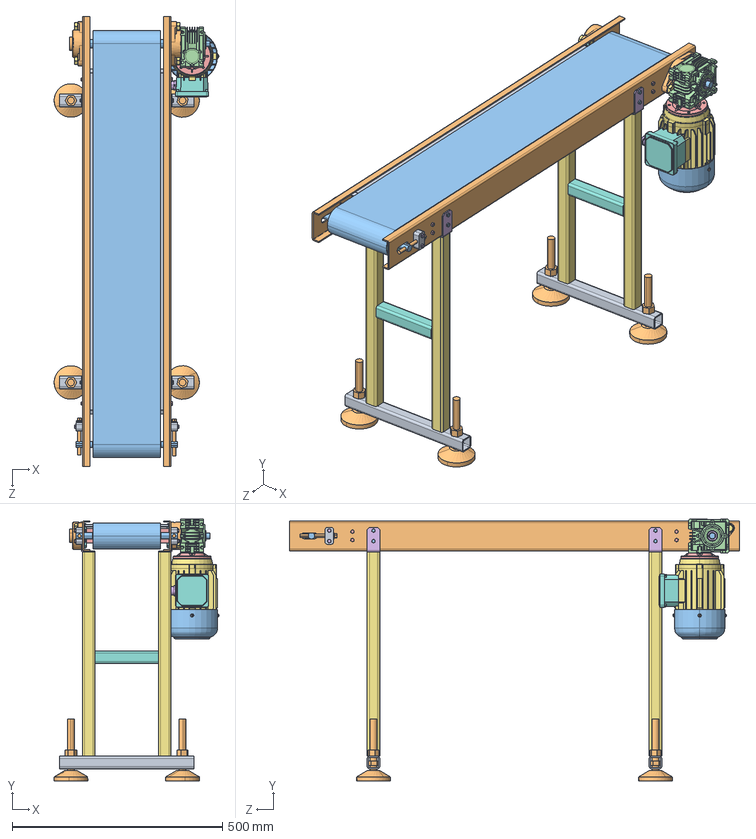
[picture p42: CAD file, 2025-02-12]
Bewegungsanalyse/SolidWorks/Montaj.STEP
391.4 x 622.5 x 1070.0 mm
KON-2 2MM ORTA SAC
KON-1 3MM SAC YAN SAC x 2
KON-3 AVARE MİL
KON-3 AVARE TAMBUR
basic internal retaining ring_am_B27.7M - 3BM1-15 x 2
hex flange machine screw_am_B18.6.7M - M8 x 1.25 x 80 Indented HFMS --38N x 2
formed hex screw_am_B18.2.3.2M - Formed hex screw, M5 x 0.8 x 12 --12WN x 8
hex nut jam_am_B18.2.4.5M - Hex jam nut, M5 x 0.8 --D-N x 8
formed hex screw_am_B18.2.3.2M - Formed hex screw, M5 x 0.8 x 16 --16WN x 8
formed hex screw_am_B18.2.3.2M - Formed hex screw, M5 x 0.8 x 20 --20WN x 4
formed hex screw_am_B18.2.3.2M - Formed hex screw, M12 x 1.75 x 20 --20WN x 4
hex nut jam_am_B18.2.4.5M - Hex jam nut, M12 x 1.75 --D-N x 4
KON-5 GERDİRME x 2
palier_fl_204_plcs x 2
KON-6 Tahrikli mil
KON-7 TAHRİK TAMBUR
KON-8 x 2
KON-9 PROFIL TUTUCU x 4
KON-10 PROFİLLER_Varsayılan<Makinelenmiş Olarak> x 2
articulated_dg80-m16-l100-c1 x 4
KON-11 BANT
E030
3063B14
ML9A
G63_B14
KL_G63
T_G63_1
GF263A
RK_G63
