KevinEppacher/Awesome_Gripper/Konstruktionsdaten/Fusion 360 Greifer/frame.stl

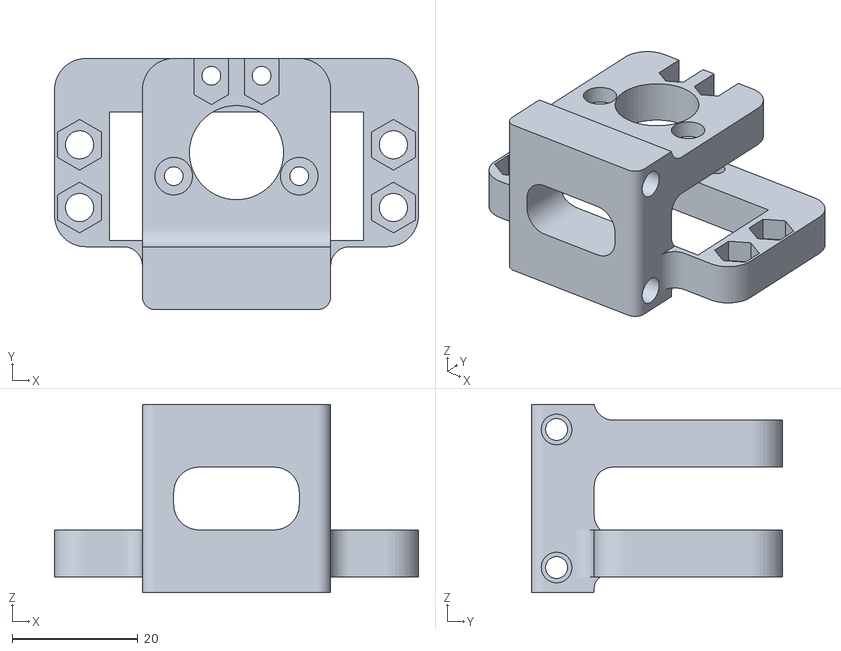
[picture p43: CAD file, 2025-02-12]
Konstruktionsdaten/Fusion 360 Greifer/frame.stl
58.0 x 40.0 x 30.0
