KevinEppacher/Awesome_Gripper/Konstruktionsdaten/Parts/Gripper/TPU_Finger.SLDPRT

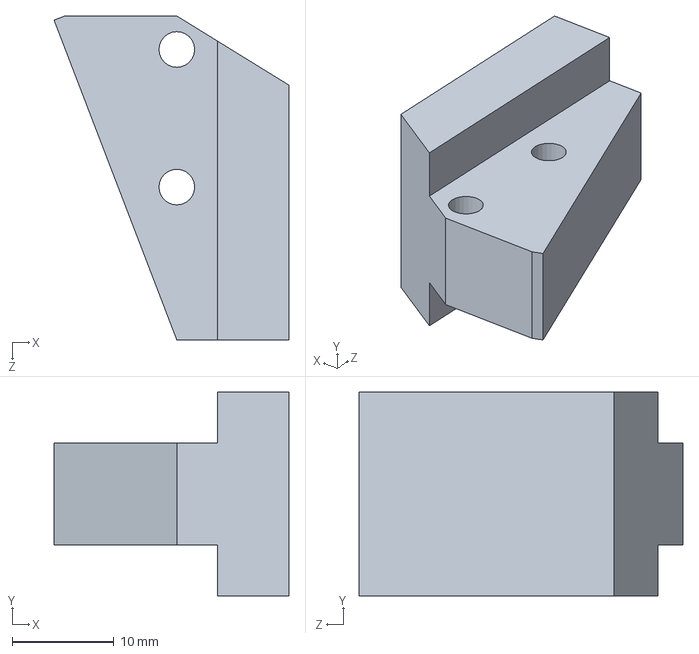
[picture p44: CAD file, 2025-02-07]
Konstruktionsdaten/Parts/Gripper/TPU_Finger.SLDPRT
23.0 x 20.0 x 31.8 mm
