KevinEppacher/Awesome_Gripper/Konstruktionsdaten/URDF_Assembly_6_DOFRA_v3/meshes/base_link.STL

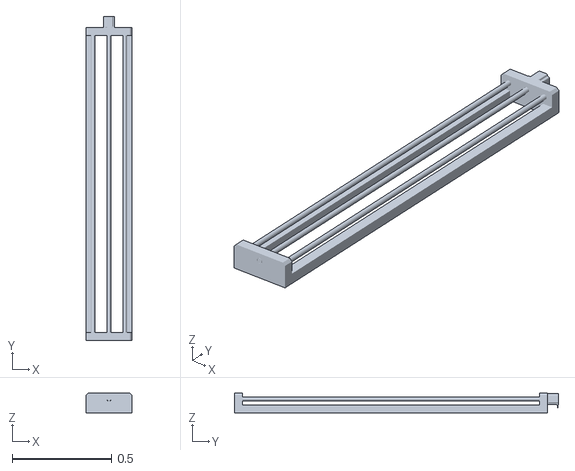
[picture p45: CAD file, 2025-02-09]
Konstruktionsdaten/URDF_Assembly_6_DOFRA_v3/meshes/base_link.STL
0.23 x 1.64 x 0.1
