KevinEppacher/Awesome_Gripper/Bewegungsanalyse/catkin_ws/src/Examples/robot/meshes/l1.STL

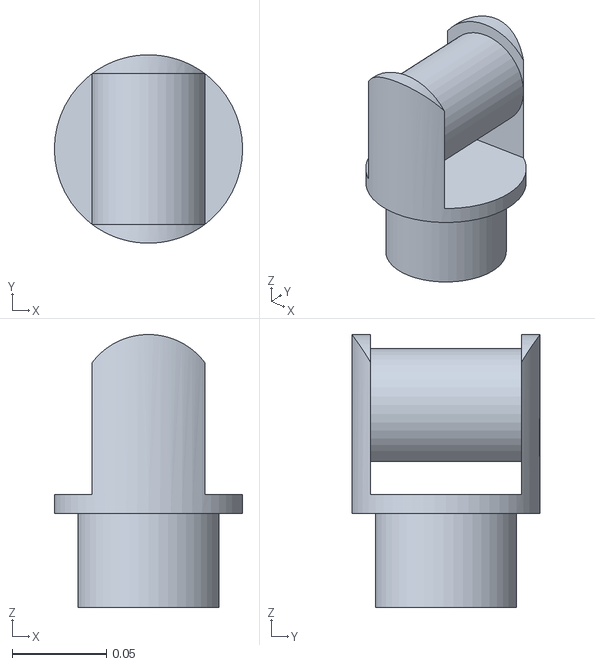
[picture p46: CAD file, 2024-10-22]
Bewegungsanalyse/catkin_ws/src/Examples/robot/meshes/l1.STL
0.1 x 0.1 x 0.145
