KevinEppacher/Awesome_Gripper/Bewegungsanalyse/catkin_ws/src/gripper/meshes/link_1_right.STL

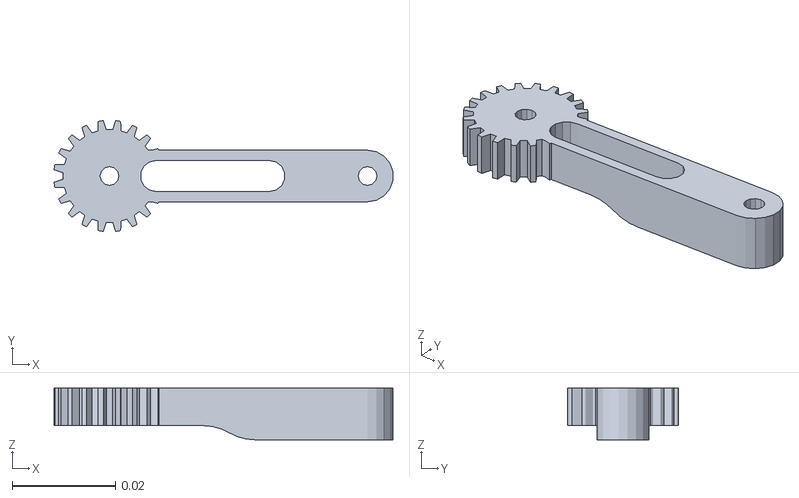
[picture p47: CAD file, 2024-10-27]
Bewegungsanalyse/catkin_ws/src/gripper/meshes/link_1_right.STL
0.0657 x 0.0215 x 0.01
