KevinEppacher/Awesome_Gripper/Bewegungsanalyse/ros2_ws/src/descriptions/urdf_6_dofra_v3/meshes/base_link.STL

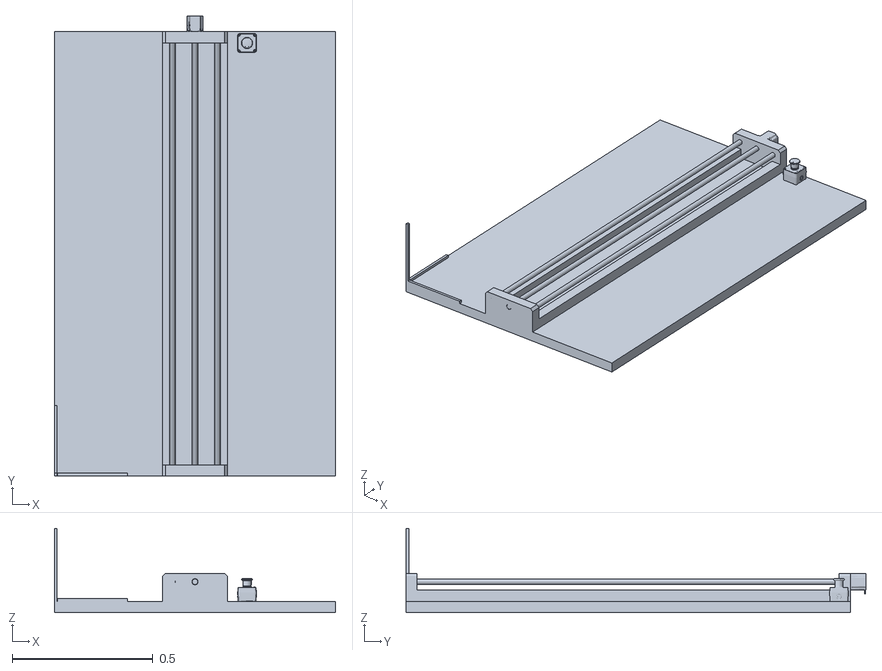
[picture p48: CAD file, 2024-10-17]
Bewegungsanalyse/ros2_ws/src/descriptions/urdf_6_dofra_v3/meshes/base_link.STL
1 x 1.64 x 0.3
