KevinEppacher/Awesome_Gripper/Konstruktionsdaten/Fusion 360 Greifer/support_lever.stl

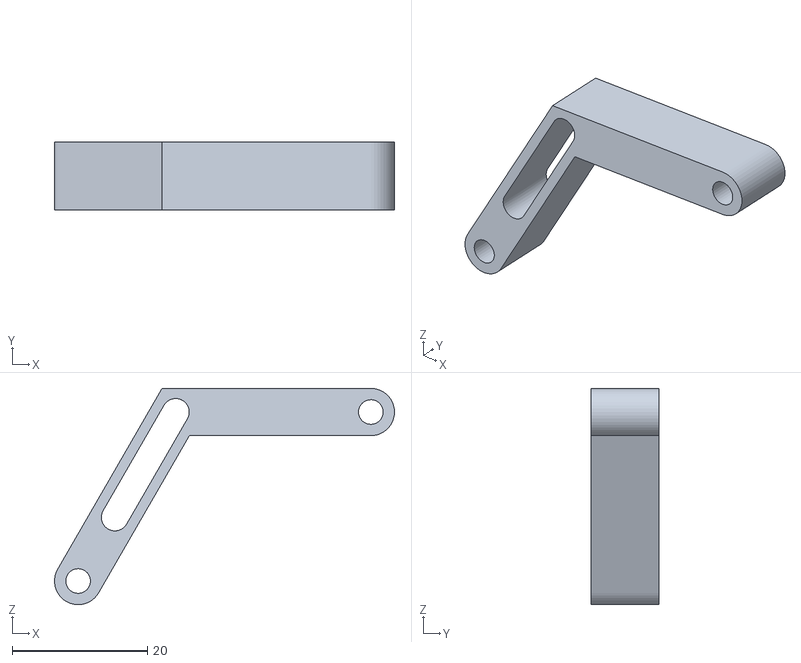
[picture p49: CAD file, 2025-02-12]
Konstruktionsdaten/Fusion 360 Greifer/support_lever.stl
50.3 x 10.0 x 32.0
