KevinEppacher/Awesome_Gripper/Konstruktionsdaten/Parts/Gripper/Hebel_Support.SLDPRT

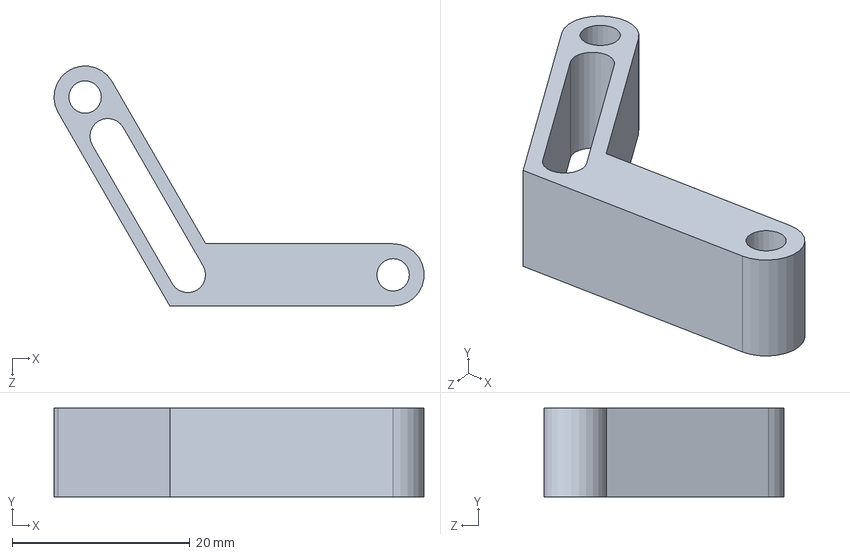
[picture p50: CAD file, 2025-02-07]
Konstruktionsdaten/Parts/Gripper/Hebel_Support.SLDPRT
41.6 x 10.0 x 27.0 mm
