KevinEppacher/Awesome_Gripper/Konstruktionsdaten/URDF_Assembly_6_DOFRA_v3/meshes/gripper.STL

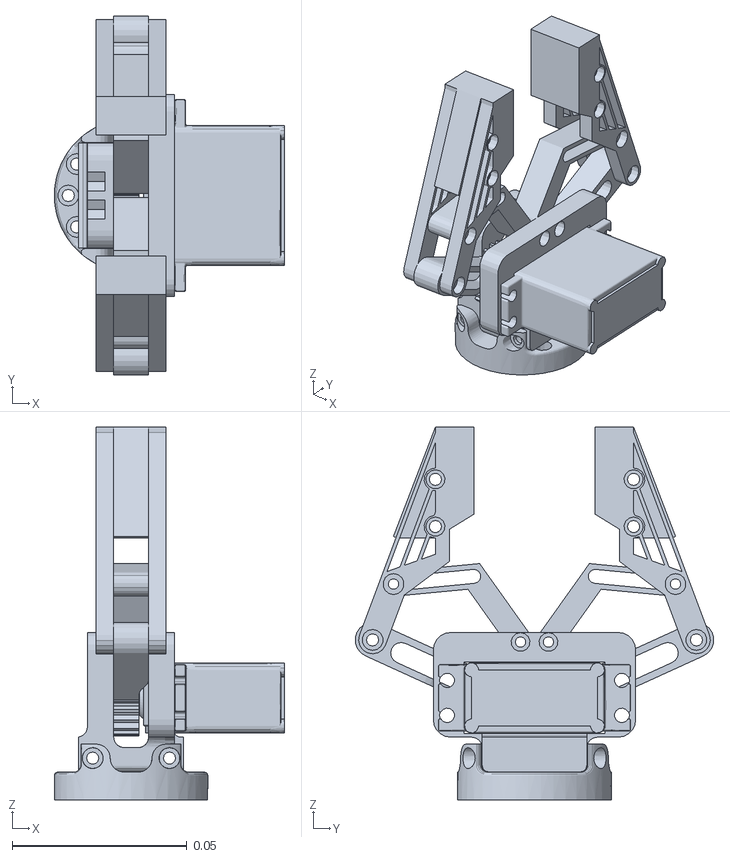
[picture p51: CAD file, 2024-10-17]
Konstruktionsdaten/URDF_Assembly_6_DOFRA_v3/meshes/gripper.STL
0.066 x 0.103 x 0.107
