KevinEppacher/Awesome_Gripper/Bewegungsanalyse/catkin_ws/src/Examples/robot/meshes/l6.STL

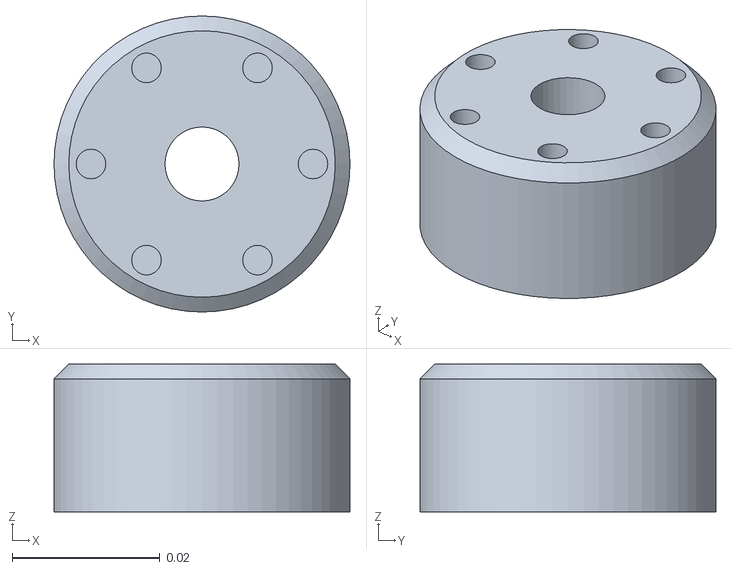
[picture p52: CAD file, 2024-10-22]
Bewegungsanalyse/catkin_ws/src/Examples/robot/meshes/l6.STL
0.04 x 0.04 x 0.02
