KevinEppacher/Awesome_Gripper/Bewegungsanalyse/catkin_ws/src/gripper/meshes/link_support_right.STL

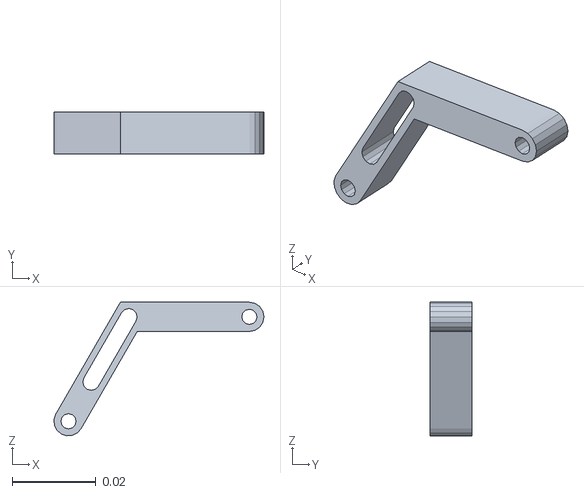
[picture p53: CAD file, 2024-10-27]
Bewegungsanalyse/catkin_ws/src/gripper/meshes/link_support_right.STL
0.0503 x 0.01 x 0.032
