KevinEppacher/Awesome_Gripper/Bewegungsanalyse/ros2_ws/src/descriptions/urdf_6_dofra_v3/meshes/link_6.STL

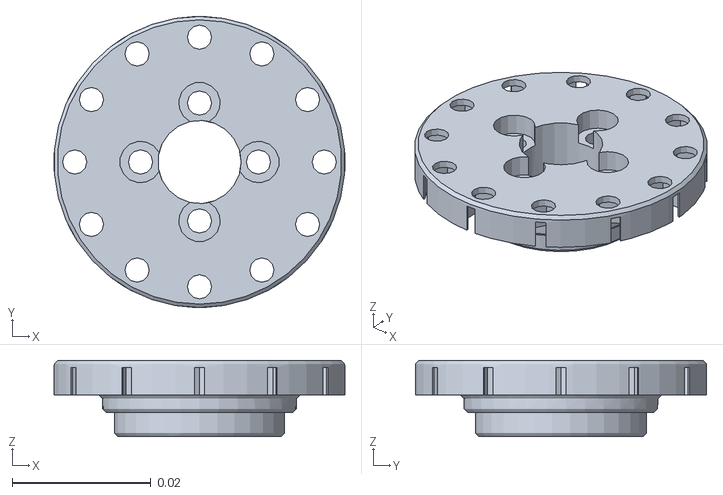
[picture p54: CAD file, 2024-10-17]
Bewegungsanalyse/ros2_ws/src/descriptions/urdf_6_dofra_v3/meshes/link_6.STL
0.042 x 0.042 x 0.011
