KevinEppacher/Awesome_Gripper/Bewegungsanalyse/SolidWorks/Bauteil_C.SLDPRT

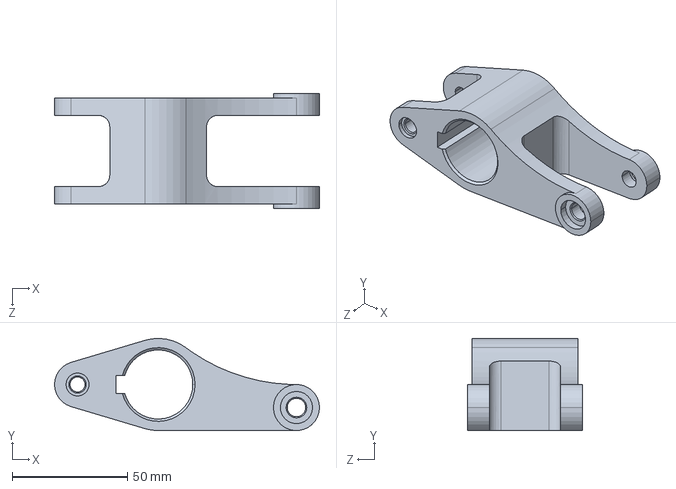
[picture p55: CAD file, 2024-10-07]
Bewegungsanalyse/SolidWorks/Bauteil_C.SLDPRT
115.0 x 40.0 x 50.0 mm
