KevinEppacher/Awesome_Gripper/Konstruktionsdaten/Fusion 360 Greifer/lever.stl

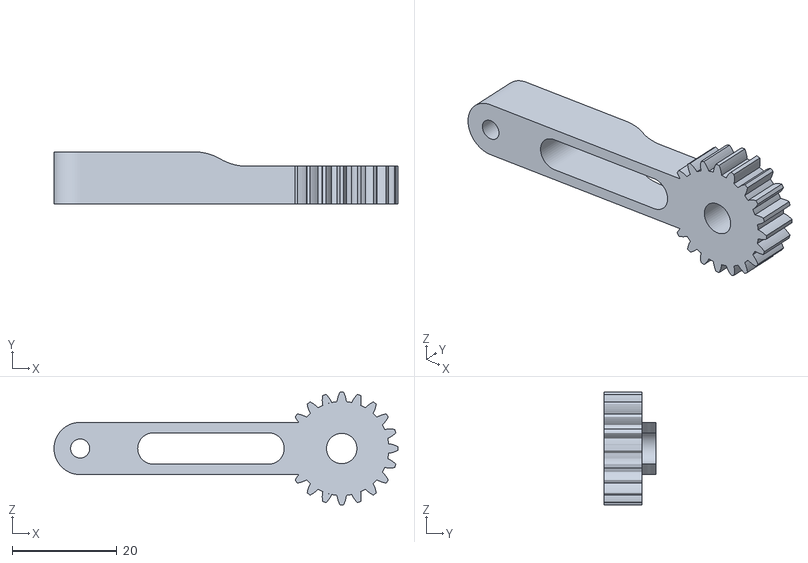
[picture p56: CAD file, 2025-02-12]
Konstruktionsdaten/Fusion 360 Greifer/lever.stl
65.8 x 10.0 x 21.5
