KevinEppacher/Awesome_Gripper/Bewegungsanalyse/catkin_ws/src/Examples/robot/meshes/base_link.STL

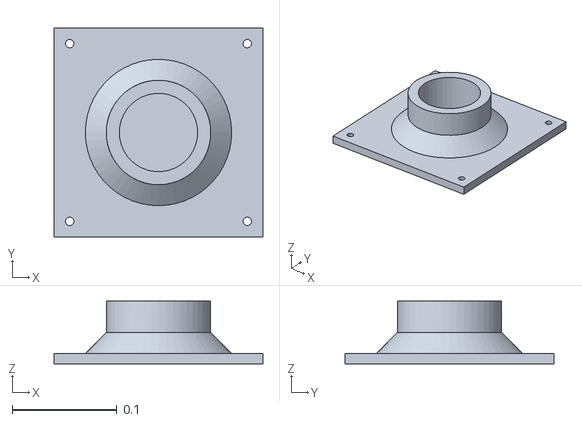
[picture p57: CAD file, 2024-10-22]
Bewegungsanalyse/catkin_ws/src/Examples/robot/meshes/base_link.STL
0.2 x 0.2 x 0.06
