KevinEppacher/Awesome_Gripper/Bewegungsanalyse/catkin_ws/src/gripper/meshes/link_3_left.STL

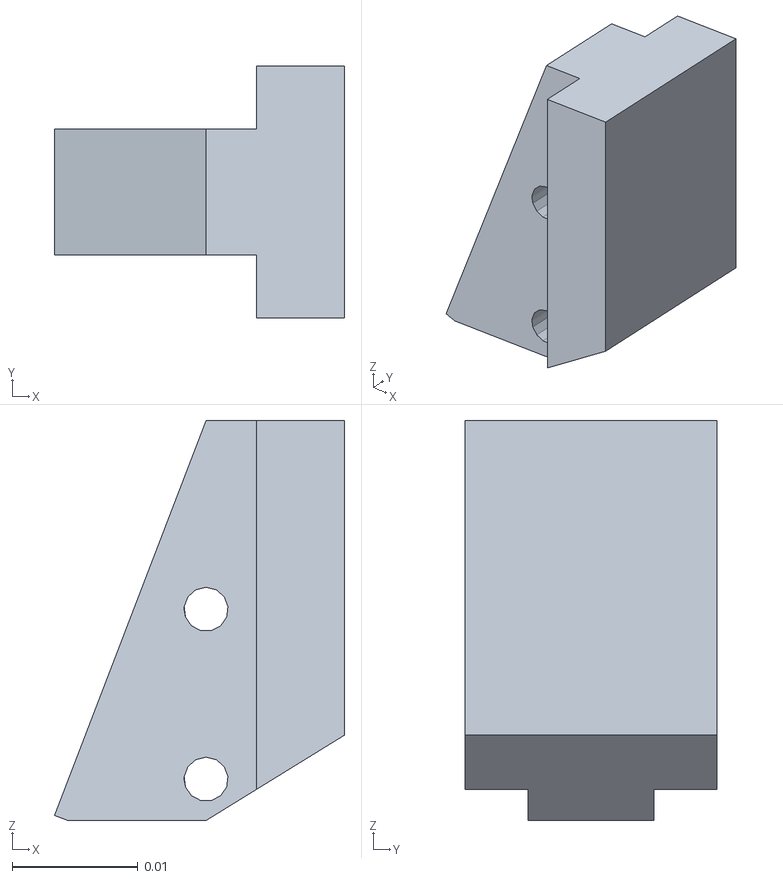
[picture p58: CAD file, 2024-10-27]
Bewegungsanalyse/catkin_ws/src/gripper/meshes/link_3_left.STL
0.023 x 0.02 x 0.0318
