KevinEppacher/Awesome_Gripper/Konstruktionsdaten/Parts/Gripper/Gripper_Frame.SLDPRT

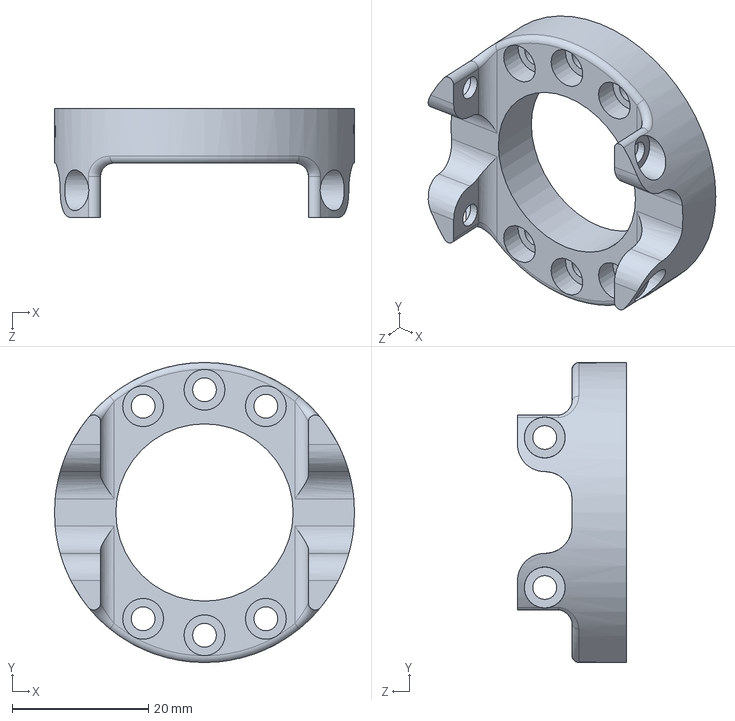
[picture p59: CAD file, 2025-02-07]
Konstruktionsdaten/Parts/Gripper/Gripper_Frame.SLDPRT
44.0 x 44.0 x 16.0 mm
