KevinEppacher/Awesome_Gripper/Bewegungsanalyse/catkin_ws/src/Examples/robot/meshes/l4.STL

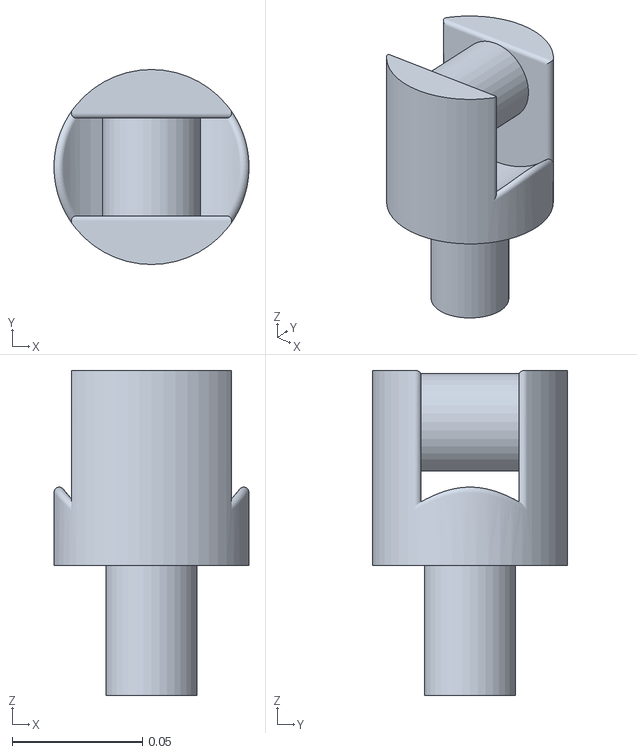
[picture p60: CAD file, 2024-10-22]
Bewegungsanalyse/catkin_ws/src/Examples/robot/meshes/l4.STL
0.075 x 0.075 x 0.125
