KevinEppacher/Awesome_Gripper/Bewegungsanalyse/catkin_ws/src/gripper/meshes/link_2_left.STL

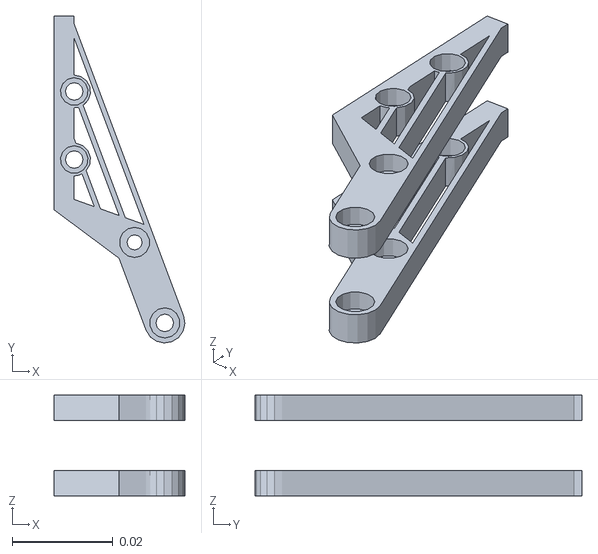
[picture p61: CAD file, 2024-10-27]
Bewegungsanalyse/catkin_ws/src/gripper/meshes/link_2_left.STL
0.026 x 0.065 x 0.02
