KevinEppacher/Awesome_Gripper/Konstruktionsdaten/Fusion 360 Greifer/finger.stl

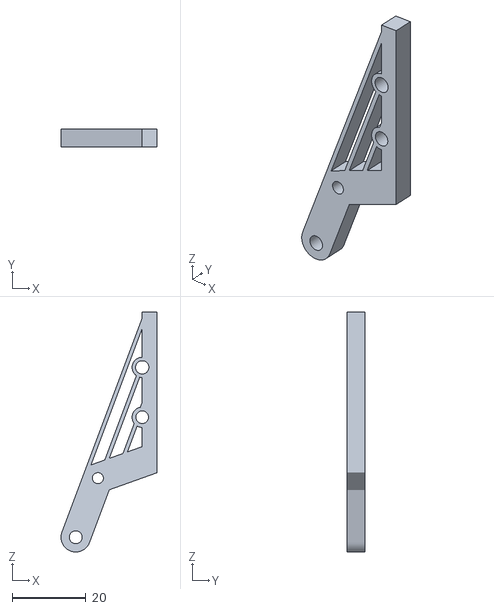
[picture p62: CAD file, 2025-02-12]
Konstruktionsdaten/Fusion 360 Greifer/finger.stl
26.0 x 5.00 x 65.0
