KevinEppacher/Awesome_Gripper/Konstruktionsdaten/Parts/Gripper/LewanSoul LD-20M  Servo 20kg.SLDPRT

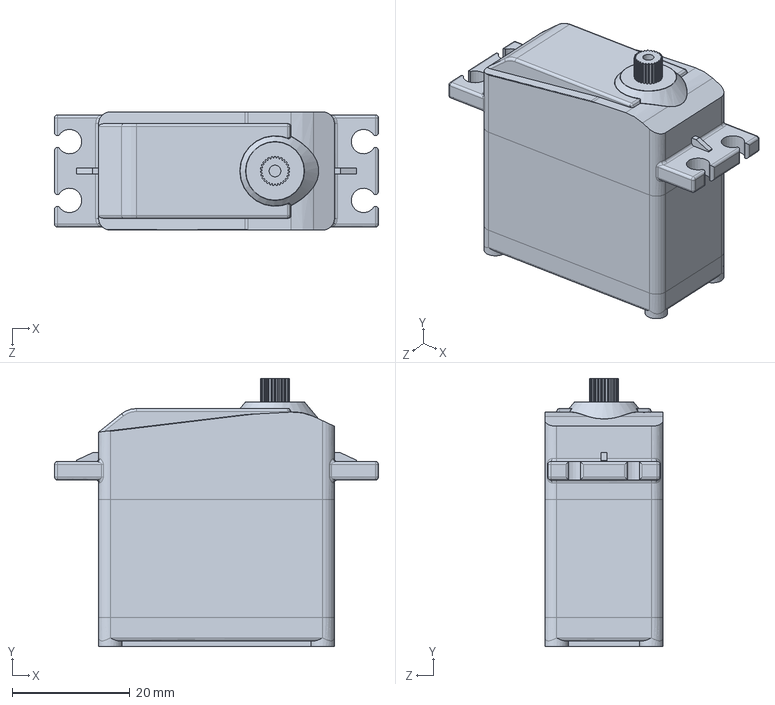
[picture p63: CAD file, 2025-02-07]
Konstruktionsdaten/Parts/Gripper/LewanSoul LD-20M Servo 20kg.SLDPRT
55.1 x 45.7 x 20.1 mm
