KevinEppacher/Awesome_Gripper/Bewegungsanalyse/catkin_ws/src/gripper/meshes/mount_link.STL

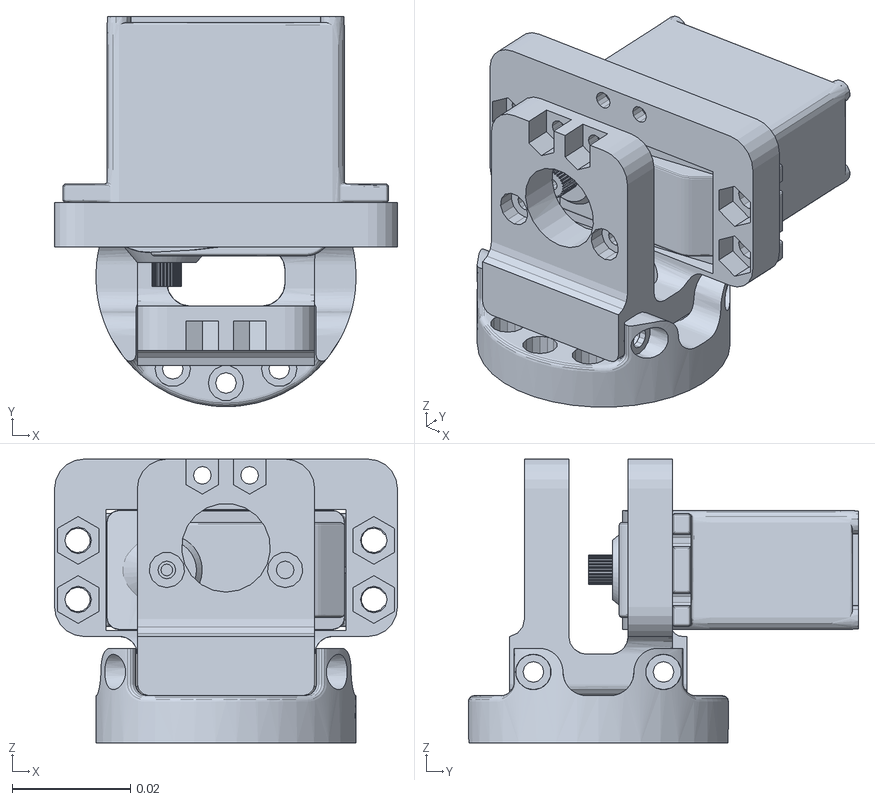
[picture p65: CAD file, 2024-10-27]
Bewegungsanalyse/catkin_ws/src/gripper/meshes/mount_link.STL
0.058 x 0.066 x 0.048
