KevinEppacher/Awesome_Gripper/Konstruktionsdaten/Fusion 360 Greifer/tip.stl

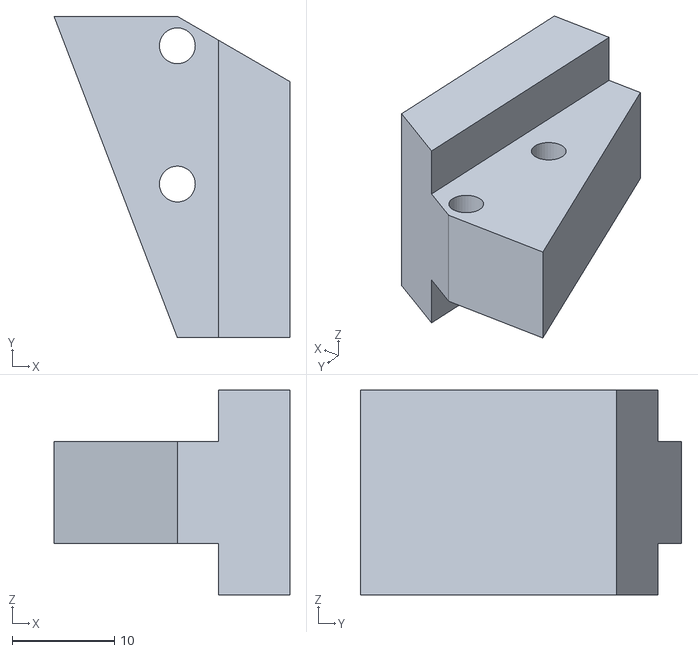
[picture p66: CAD file, 2025-02-12]
Konstruktionsdaten/Fusion 360 Greifer/tip.stl
23.0 x 31.4 x 20.0
