KevinEppacher/Awesome_Gripper/Konstruktionsdaten/Parts/Gripper/Hebel.SLDPRT

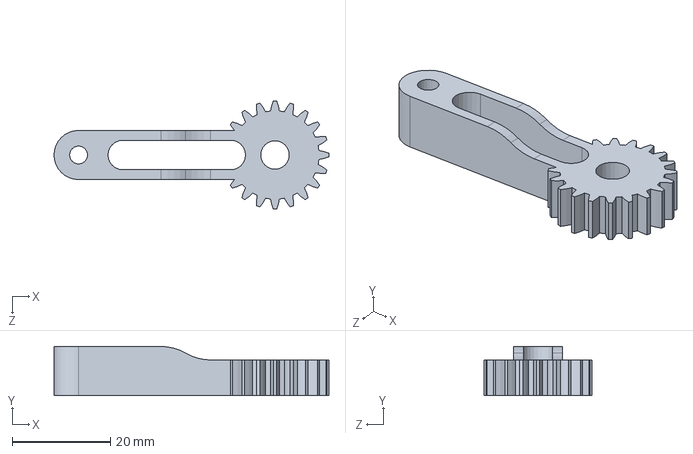
[picture p68: CAD file, 2025-02-07]
Konstruktionsdaten/Parts/Gripper/Hebel.SLDPRT
56.0 x 10.0 x 22.0 mm
