KevinEppacher/Awesome_Gripper/Konstruktionsdaten/Parts/Gripper/Hebel_2.SLDPRT

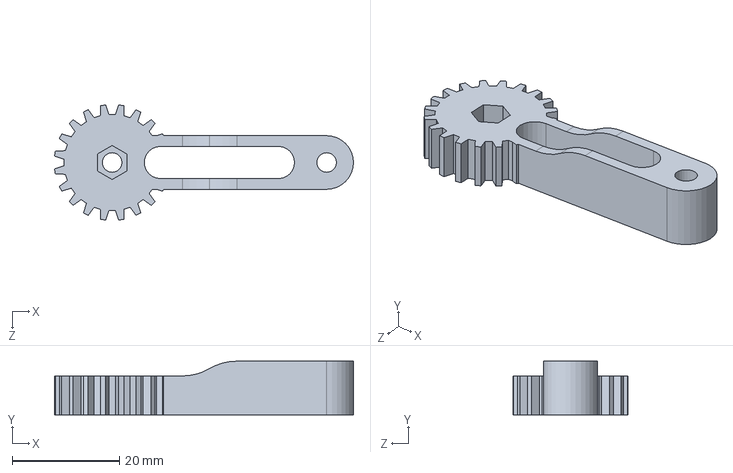
[picture p69: CAD file, 2025-02-07]
Konstruktionsdaten/Parts/Gripper/Hebel_2.SLDPRT
55.7 x 10.0 x 21.5 mm
