KevinEppacher/Awesome_Gripper/Konstruktionsdaten/Assembly/Gripper/Gripper.SLDASM

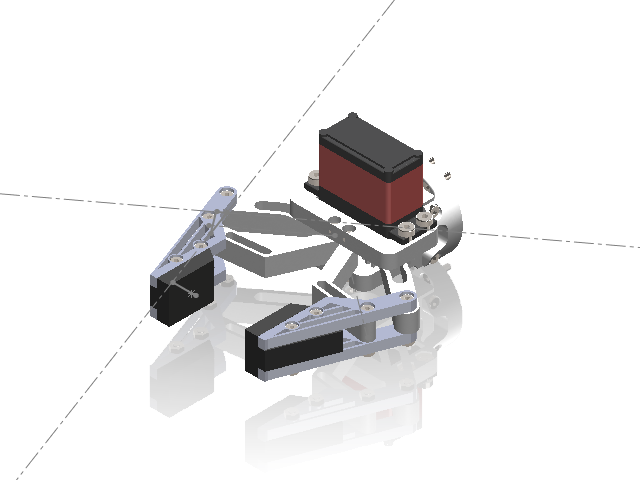
[picture p70: CAD file, 2025-02-07]
Konstruktionsdaten/Assembly/Gripper/Gripper.SLDASM
Gripper_Frame
LewanSoul LD-20M Servo 20kg
Gripper_Frame_2
socket head thin cap screw_din x 26
Hebel
Hebel_Support x 2
Gripper_FInger x 2
SpiegelnGripper_FInger x 2
hex nut style 1 gradeab_din x 15
TPU_Finger x 2
Hebel_2
