KevinEppacher/Awesome_Gripper/Bewegungsanalyse/SolidWorks/Assembly_Bewegungsanalyse.SLDASM

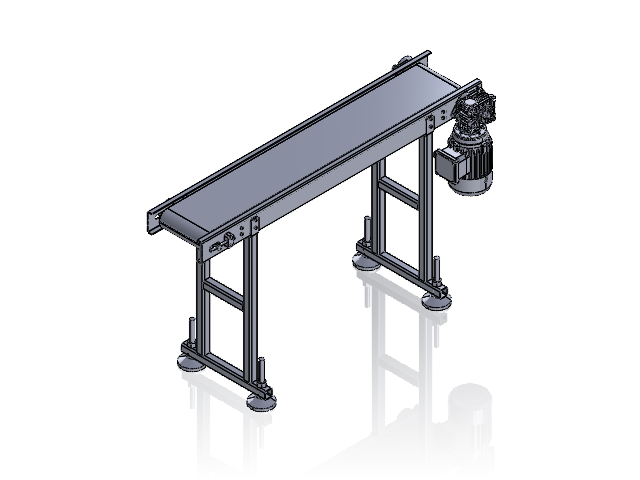
[picture p71: CAD file, 2025-02-12]
Bewegungsanalyse/SolidWorks/Assembly_Bewegungsanalyse.SLDASM
6002_01.STEP x 2
6002_02.STEP x 2
6002_03.STEP x 2
6002_04.STEP x 2
6002_05.STEP x 2
6002_06.STEP x 2
6002_07.STEP x 2
6002_08.STEP x 2
6002_09.STEP x 2
6002_10.STEP x 2
6002_11.STEP x 2
6002_12.STEP x 2
KON-9 PROFIL TUTUCU.STEP x 4
KON-10 PROFİLLER_Varsayılan_Makinelenmiş Olarak_.STEP x 2
articulated_dg80-m16-l100-c1.STEP x 4
E030.STEP
3063B14.STEP
ML9A.STEP
G63_B14.STEP
KL_G63.STEP
T_G63_1.STEP
GF263A.STEP
RK_G63.STEP
KON-2 2MM ORTA SAC.STEP
KON-1 3MM SAC YAN SAC.STEP x 2
KON-3 AVARE MİL.STEP
KON-3 AVARE TAMBUR.STEP
basic internal retaining ring_am_B27.7M - 3BM1-15.STEP x 2
hex flange machine screw_am_B18.6.7M - M8 x 1.25 x 80 Indented HFMS --38N.STEP x 2
formed hex screw_am_B18.2.3.2M - Formed hex screw, M5 x 0.8 x 12 --12WN.STEP x 8
hex nut jam_am_B18.2.4.5M - Hex jam nut, M5 x 0.8 --D-N.STEP x 8
formed hex screw_am_B18.2.3.2M - Formed hex screw, M5 x 0.8 x 16 --16WN.STEP x 8
formed hex screw_am_B18.2.3.2M - Formed hex screw, M5 x 0.8 x 20 --20WN.STEP x 4
formed hex screw_am_B18.2.3.2M - Formed hex screw, M12 x 1.75 x 20 --20WN.STEP x 4
hex nut jam_am_B18.2.4.5M - Hex jam nut, M12 x 1.75 --D-N.STEP x 4
KON-5 GERDİRME.STEP x 2
palier_fl_204_plcs.STEP x 2
KON-6 Tahrikli mil.STEP
KON-7 TAHRİK TAMBUR.STEP
KON-8.STEP x 2
KON-11 BANT.STEP
