KevinEppacher/Awesome_Gripper/(list of files, cad)

Other CAD files:
Konstruktionsdaten/Parts/Gripper/SpiegelnGripper_FInger.SLDPRT
Konstruktionsdaten/Fusion 360 Greifer/lever_offset.stl
Konstruktionsdaten/Parts/Gripper/Gripper_Frame_2.SLDPRT
Bewegungsanalyse/catkin_ws/src/gripper/meshes/link_support_left.STL
Konstruktionsdaten/Fusion 360 Greifer/baseplate.stl
Konstruktionsdaten/Parts/Gripper/Gripper_FInger.SLDPRT
Bewegungsanalyse/catkin_ws/src/gripper/meshes/link_3_right.STL
Bewegungsanalyse/catkin_ws/src/gripper/meshes/link_2_right.STL
Bewegungsanalyse/SolidWorks/Montaj.SLDPRT
Konstruktionsdaten/Assembly/Gripper/Gripper_without_bolts.SLDASM
Konstruktionsdaten/Parts/Gripper/Gripper_without_bolts.SLDASM
Konstruktionsdaten/Parts/Robot/Gelenk_1_V2.0.SLDASM
Konstruktionsdaten/Parts/Robot/Gelenk_3_V2.SLDASM
