KevinEppacher/Awesome_Gripper/Baugruppenzeichnung(Greifer)/Gripper Zeichnung.pdf

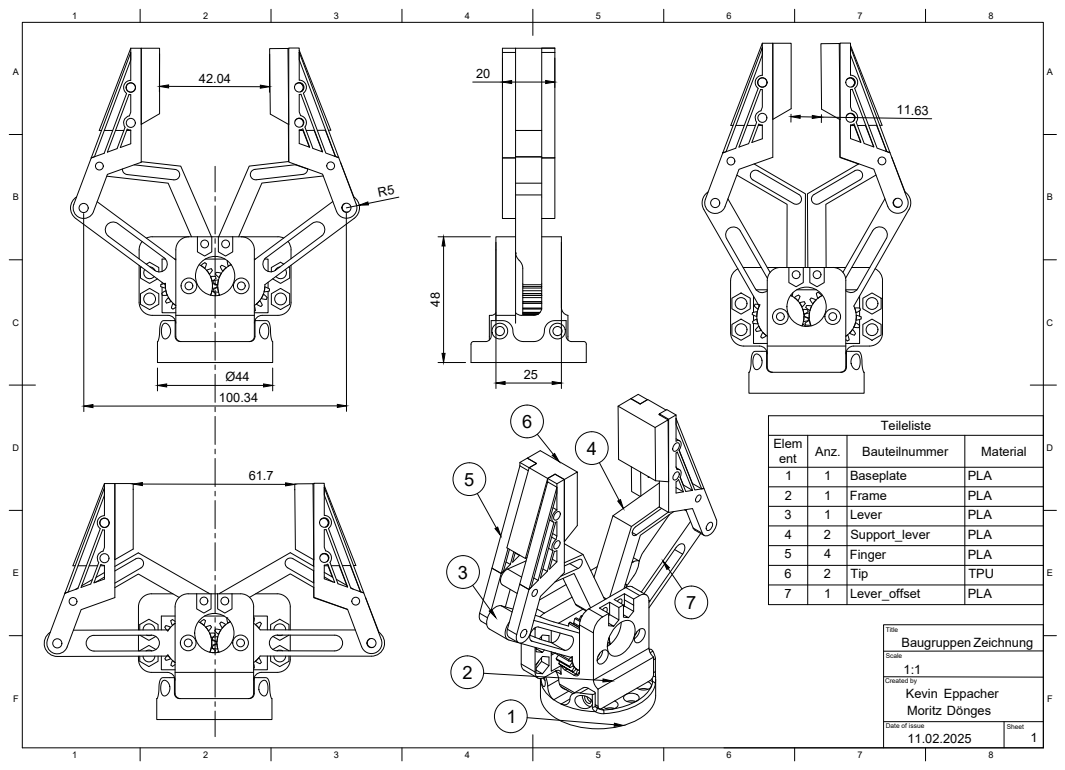
[picture p72: page 1]
ent; Anz.; Bauteilnummer; Material 1; Baseplate; PLA 2; Frame; PLA 3; Lever; PLA 4; Support_lever; PLA 5; Finger; PLA 6; Tip; TPU 7; Lever_offset; PLA 1 23; Created by; Date of issue; Sheet 1 A; 8 BCDEF; ABCDEF R5; Baugruppen Zeichnung; Kevin Eppacher Moritz Dönges
