KevinEppacher/Awesome_Gripper/Bewegungsanalyse/ros2_ws/src/configs/six_dofra_config/config/initial_positions.yaml

# Default initial positions for urdf_6_dofra_v3's ros2_control fake system

initial_positions:
  joint_1: 0
  joint_2: 0
  joint_3: 0
  joint_4: 0
  joint_5: 0
  joint_6: 0
  linear_axis: 0
