KevinEppacher/Awesome_Gripper/(commit log)

2024-10-07 Added External Part
    [Bauteil_C.SLDPRT]
2024-10-17 Moveit Config
    [URDF_Assembly_6_DOFRA_v3.csv, URDF_Assembly_6_DOFRA_v3.urdf, base_link.STL, fake_controllers.yaml, gazebo_controllers.yaml, joint_limits.yaml, linear_sledge.STL, link_6.STL]
2024-10-22 Hier Mo
    [URDF_Assembly_6_DOFRA_v3.urdf, fake_controllers.yaml, gazebo_controllers.yaml, joint_limits.yaml, ros_controllers.yaml]
2024-10-22 Hier Mo 2
    [URDF_Assembly_6_DOFRA_v3.urdf, ros_controllers.yaml]
2024-10-22 Example Robot
    [URDF_Assembly_6_DOFRA_v3.urdf, arm_urdf.urdf, base_link.STL, fake_controllers.yaml, gazebo_controllers.yaml, gazebo_urdf_6_dofra_v3.urdf, joint_limits.yaml, l1.STL]
2024-10-23 Ois an schaas
    [URDF_Assembly_6_DOFRA_v3.urdf, base_link.STL, fake_controllers.yaml, gazebo_controllers.yaml, gazebo_urdf_6_dofra_v3.urdf, joint_limits.yaml, linear_sledge.STL, link_6.STL]
2024-10-23 Simulation Funktioniert endlich
    [URDF_Assembly_6_DOFRA_v3.urdf, robot.urdf]
2024-10-23 Unnedigen Packages entfernt
    [arm_urdf.urdf, base_link.STL, fake_controllers.yaml, gazebo_controllers.yaml, gazebo_urdf_6_dofra_v3.urdf, joint_limits.yaml, linear_sledge.STL, link_6.STL]
2024-10-24 Two Conveyors and gripper arm xacro
    [URDF_Assembly_6_DOFRA_v3.xacro, gripper_test.xacro, robot_with_gripper.urdf.xacro]
2024-10-27 Alles komplett fehlgeschalgen. Keine Ahnung wie es weiter geht
    [gripper_all_joints.urdf.xacro]
2025-02-03 Remodified CAD. Added calculations for min. Torque. Moved git ignore. Deleted devel and build
2025-02-03 Now added calculations for min. Torque
2025-02-03 Fixed CAD again
    [Gripper.SLDASM, Gripper_FInger.SLDPRT, Gripper_Frame.SLDPRT, Gripper_Frame_2.SLDPRT, Hebel.SLDPRT, Hebel_2.SLDPRT, Hebel_Support.SLDPRT, LewanSoul LD-20M Servo 20kg.SLDPRT]
2025-02-04 Modified SMath File
    [Gripper.SLDASM, SpiegelnGripper_FInger.SLDPRT]
2025-02-05 Modified Awesome Gripper Word Dokumentation
2025-02-07 Added gitignore, submodules, changed gripper and simulation
    [base_link.STL, l1.STL, l2.STL, l3.STL, l4.STL, l5.STL, l6.STL, robot.csv]
2025-02-07 Created robot config package
    [URDF_Assembly_6_DOFRA_v3.csv, URDF_Assembly_6_DOFRA_v3.urdf, URDF_Assembly_6_DOFRA_v3.xacro, base_link.STL, gripper_test.xacro, joint_limits.yaml, linear_sledge.STL, link_6.STL]
2025-02-08 New architecture
    [six_dofra_gazebo.xacro]
2025-02-09 New Base
    [base_link.STL]
2025-02-12 Fusion 360 Baugrppe, Dokumentation, FE-Analyse
    [Gripper_Baugruppe.stl, baseplate.stl, finger.stl, frame.stl, lever.stl, lever_offset.stl, support_lever.stl, tip.stl]
2025-02-12 Doku Anpassung, Bewegungsanalyse Fotos hinzugefügt
    [Assembly_Bewegungsanalyse.SLDASM, Bauteil_C.SLDPRT, Montaj.SLDPRT, Montaj.STEP]
